sideridispas/SdR_Thesis/README.md

# SdR_Thesis
Code for my thesis. All libraries that I had to include and all the code that I wrote for the 2 arduinos and the processing apps.
