sideridispas/SdR_Thesis/Thesis_Report/chapters/4.ControlData.tex

Introduction text here...
mpla mpla mpla about the control of the PCB and the data handling

\section{Requirements}
List of technical requirements such as
time
I2C communication
Data format
Etc

\section{Main CPU and Logic}
Raspberry Pi
OS, Wifi, Cron timing, remote control etc

\section{Data Logging and Storing}
Data logging from the PCB
Local storing
Cloud uploading
