sideridispas/SdR_Thesis/Thesis_Report/chapters/5.FinalDevice.tex

Introduction text maybe here...
mpla mpla mpla

\section{Physical Requirements}
IP66
Weather resistance
dimensions
temperature and UV exposure
etc

\section{Power Supply}
5V Voltage regulator
24V Power supply externally
Custom Voltage regulation PCB
Alternatives

\section{Enclosure and Connections}
Enclosure selection
PV connectors
Power supply connectors
Temperature 1-wire bus connector
Photos and 3D draft

\section{Calibration}
Introduction for calibration like we need it after we have all the components with their resistances (connectors, welded points etc)

\subsection{Tools and Setup}
Tools that were used
Circuit of the calibration setup

\subsection{Process}
Initial measurement
Calculation of Correction parameters
Update of atmega code
Final Measurement
Validation of calibration

Results (???)
