sideridispas/SdR_Thesis/Thesis_Report/chapters/system_abstract.png

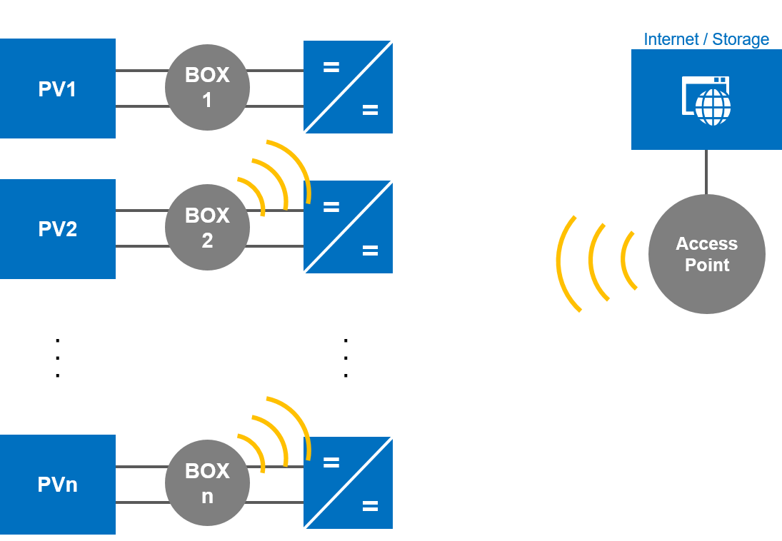
Thesis_Report/chapters/system_abstract.png
