sideridispas/SdR_Thesis/Thesis_Report/images/Chapter_3/PV_demoPCB_bottom.jpg

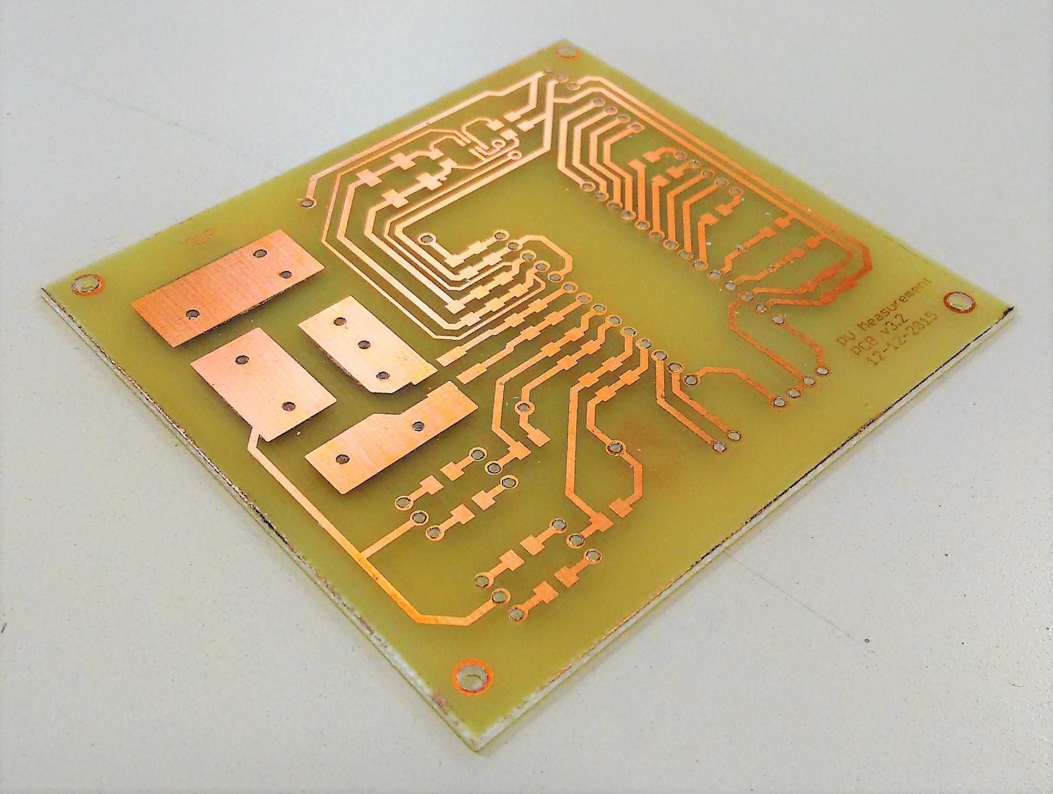
Thesis_Report/images/Chapter_3/PV_demoPCB_bottom.jpg
