sideridispas/SdR_Thesis/Calibration/After Calibration/Calibrated.xlsx

DMM | PCB | Error
4.923094 | 4.9087
4.923264 | 4.9214
4.923207 | 4.9017
4.923103 | 4.9186
4.923118 | 4.9094
4.923204 | 4.914
4.923100 | 4.9205
4.923058 | 4.9148
1.981027 | 1.9657
1.977889 | 1.9713
1.977085 | 1.9683
1.976761 | 1.9661
1.976463 | 1.9687
1.976314 | 1.9652
0.998007 | 1.9632
0.997257 | 1.1259
0.996954 | 0.9889
0.996847 | 0.9811
0.996625 | 0.9792
0.996527 | 0.976
0.996494 | 0.9851
0.996425 | 0.976
0.996337 | 0.9781
0.996292 | 0.9931
0.996339 | 0.9775
0.996231 | 0.9765
0.996199 | 0.9818
0.996292 | 0.9854
0.996162 | 0.9795
1.974760 | 0.9894
1.975188 | 0.979
1.975251 | 0.9814
1.975322 | 0.9744
1.975424 | 0.9734
1.975456 | 0.985
1.975439 | 0.9773
1.975459 | 1.9522
1.975522 | 1.9606
1.975474 | 1.9684
1.975495 | 1.9578
1.975578 | 1.9577
1.975495 | 1.961
1.975519 | 1.9576
1.975523 | 1.9563
3.864551 | 1.9592
3.932944 | 1.9614
3.933947 | 1.9624
3.934322 | 1.9668
3.934611 | 1.9597
3.934659 | 1.9562
3.934745 | 1.9538
3.934823 | 1.9585
3.934968 | 1.9605
3.934924 | 1.9581
3.934962 | 1.962
3.935087 | 1.956
3.935013 | 3.9248
3.935034 | 3.9251
3.935038 | 3.9149
3.935126 | 3.9175
5.882725 | 3.9244
5.901049 | 3.9215
5.902201 | 3.9126
5.902701 | 3.926
5.902892 | 3.926
5.903056 | 3.9301
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
