sideridispas/SdR_Thesis/Calibration/BeforeCalibration/1/calibration.xlsx

DMM | PCB | Voltage step | DMM-Avg | PCB-Avg | Error
0.995823 | 1.0289 | 1 | 0.995849 | 1.0289 | 3.318891
0.995832 | 1.0289 | 5 | 4.922126 | 4.97372 | 1.048209
0.995915 | 1.029 | 2 | 1.976426 | 2.014557143 | 1.929308
0.995834 | 1.0286 | 1 | 0.996097 | 1.029552632 | 3.358656
0.995824 | 1.0288 | 2 | 1.975369 | 2.013094737 | 1.909792
0.995827 | 1.029 | 4 | 3.934673 | 3.9818 | 1.197734
0.995926 | 1.0289 | 6 | 5.902928 | 5.9595 | 0.958374
0.995827 | 1.0288 | 8 | 7.872826 | 7.938952632 | 0.839935
0.995833 | 1.0291 | 10 | 9.843440 | 9.918910526 | 0.766707
0.995892 | 1.0292 | 12 | 11.814864 | 11.89970526 | 0.718090
0.995833 | 1.0291 | 14 | 13.788631 | 13.88143158 | 0.673025
0.995819 | 1.0285 | 16 | 15.760363 | 15.86362632 | 0.655211
0.995861 | 4.95 | 18 | 17.733738 | 17.84630556 | 0.634765
0.995884 | 4.9708 | 20 | 19.699575 | 19.820695 | 0.614837
0.995828 | 4.973 | 22 | 21.664912 | 21.79542632 | 0.602423
0.995824 | 4.9736 | 24 | 23.632830 | 23.7718 | 0.588038
4.919913 | 4.974 | 26 | 25.600987 | 25.74749474 | 0.572275
4.921187 | 4.974 | 28 | 27.560138 | 27.71546316 | 0.563586
4.921830 | 4.9746 | 30 | 29.526013 | 29.68931579 | 0.553082
4.922060 | 4.9745 | 32 | 31.490387 | 31.6583 | 0.533221
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
