sideridispas/SdR_Thesis/Calibration/BeforeCalibration/2/data_2016-05-23-17.csv

Date | Time | I | V1 | V2 | P | Temp1 | Temp2 | Temp3 | Temp4 | Temp5 | Temp6 | Temp7 | Temp8 | Temp9 | Temp10 | Temp11 | Temp12 | Temp13 | Temp14 | Temp15 | Temp16 | Temp17 | Temp18 | Temp19 | Temp20 | ComputerTime | Corrupted
23/5/16 | 3:26:33 | 2.3385 | 7.9401 | 50.7375 | 18.5681 | 99.99 | 99.99 | 99.99 | 99.99 | 99.99 | 99.99 | 99.99 | 99.99 | 99.99 | 99.99 | 99.99 | 99.99 | 99.99 | 99.99 | 99.99 | 99.99 | 99.99 | 99.99 | 99.99 | 99.99 | 2016-05-23 17:25:35.253465
23/5/16 | 14:45:34 | 1.8224 | 7.9399 | 7.9162 | 14.4700 | 99.99 | 99.99 | 99.99 | 99.99 | 99.99 | 99.99 | 99.99 | 99.99 | 99.99 | 99.99 | 99.99 | 99.99 | 99.99 | 99.99 | 99.99 | 99.99 | 99.99 | 99.99 | 99.99 | 99.99 | 2016-05-23 17:25:35.570091
23/5/16 | 14:24:35 | 1.8223 | 7.9396 | 7.9161 | 14.4688 | 99.99 | 99.99 | 99.99 | 99.99 | 99.99 | 99.99 | 99.99 | 99.99 | 99.99 | 99.99 | 99.99 | 99.99 | 99.99 | 99.99 | 99.99 | 99.99 | 99.99 | 99.99 | 99.99 | 99.99 | 2016-05-23 17:25:36.692690
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
