sideridispas/SdR_Thesis/Calibration/BeforeCalibration/2/meas0003.csv

 |  | 23-MAY-2016 | 18:25:25 | 2199203
7.8740410E+00 | Vdc
7.8740500E+00 | Vdc
7.8740980E+00 | Vdc
7.8740210E+00 | Vdc
7.8740380E+00 | Vdc
7.8741040E+00 | Vdc
1.0009973E+00 | Vdc
9.9898150E-01 | Vdc
9.9808070E-01 | Vdc
9.9765600E-01 | Vdc
9.9721940E-01 | Vdc
9.9699240E-01 | Vdc
9.9686820E-01 | Vdc
9.9665940E-01 | Vdc
9.9655900E-01 | Vdc
9.9648190E-01 | Vdc
9.9644550E-01 | Vdc
9.9632460E-01 | Vdc
9.9625610E-01 | Vdc
9.9627310E-01 | Vdc
9.9617060E-01 | Vdc
1.9746480E+00 | Vdc
1.9751190E+00 | Vdc
1.9751810E+00 | Vdc
1.9752640E+00 | Vdc
1.9753420E+00 | Vdc
1.9754550E+00 | Vdc
1.9753600E+00 | Vdc
1.9754070E+00 | Vdc
1.9754730E+00 | Vdc
1.9754160E+00 | Vdc
1.9754100E+00 | Vdc
1.9754700E+00 | Vdc
1.9754760E+00 | Vdc
1.9754310E+00 | Vdc
1.9754100E+00 | Vdc
3.9286160E+00 | Vdc
3.9332880E+00 | Vdc
3.9340140E+00 | Vdc
3.9343570E+00 | Vdc
3.9345830E+00 | Vdc
3.9348030E+00 | Vdc
3.9348000E+00 | Vdc
3.9348690E+00 | Vdc
3.9349820E+00 | Vdc
3.9349550E+00 | Vdc
3.9349910E+00 | Vdc
3.9350980E+00 | Vdc
3.9350710E+00 | Vdc
3.9350710E+00 | Vdc
3.9350860E+00 | Vdc
3.9351990E+00 | Vdc
5.8847400E+00 | Vdc
5.9008980E+00 | Vdc
5.9022470E+00 | Vdc
5.9027560E+00 | Vdc
5.9030870E+00 | Vdc
5.9032240E+00 | Vdc
5.9033550E+00 | Vdc
5.9034980E+00 | Vdc
5.9035010E+00 | Vdc
5.9035480E+00 | Vdc
5.9036940E+00 | Vdc
5.9036410E+00 | Vdc
5.9036850E+00 | Vdc
5.9037000E+00 | Vdc
5.9038190E+00 | Vdc
5.9037450E+00 | Vdc
7.8622590E+00 | Vdc
7.8715220E+00 | Vdc
7.8725470E+00 | Vdc
7.8729840E+00 | Vdc
7.8733300E+00 | Vdc
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
7.8678630E+00 | Vdc
7.8693520E+00 | Vdc
7.8697150E+00 | Vdc
7.8695420E+00 | Vdc
7.8701350E+00 | Vdc
7.8703760E+00 | Vdc
7.8707360E+00 | Vdc
7.8705700E+00 | Vdc
7.8706740E+00 | Vdc
7.8705460E+00 | Vdc
7.8705280E+00 | Vdc
7.8709180E+00 | Vdc
7.8714750E+00 | Vdc
 |  | 23-MAY-2016 | 18:33:50
