sideridispas/SdR_Thesis/Calibration/After Calibration/data_2016-05-23-20.csv

Date | Time | I | V1 | V2 | P | Temp1 | Temp2 | Temp3 | Temp4 | Temp5 | Temp6 | Temp7 | Temp8 | Temp9 | Temp10 | Temp11 | Temp12 | Temp13 | Temp14 | Temp15 | Temp16 | Temp17 | Temp18 | Temp19 | Temp20 | ComputerTime | Corrupted
23/5/16 | 0:5:8 | 1.4462 | 4.9087 | -15.5217 | 7.0993 | 99.99 | 99.99 | 99.99 | 99.99 | 99.99 | 99.99 | 99.99 | 99.99 | 99.99 | 99.99 | 99.99 | 99.99 | 99.99 | 99.99 | 99.99 | 99.99 | 99.99 | 99.99 | 99.99 | 99.99 | 2016-05-23 20:09:10.144436
23/5/16 | 20:8:9 | 1.1234 | 4.9214 | 4.9923 | 5.5285 | 99.99 | 99.99 | 99.99 | 99.99 | 99.99 | 99.99 | 99.99 | 99.99 | 99.99 | 99.99 | 99.99 | 99.99 | 99.99 | 99.99 | 99.99 | 99.99 | 99.99 | 99.99 | 99.99 | 99.99 | 2016-05-23 20:09:10.461809
23/5/16 | 20:12:10 | 1.1233 | 4.9017 | 4.9844 | 5.5062 | 99.99 | 99.99 | 99.99 | 99.99 | 99.99 | 99.99 | 99.99 | 99.99 | 99.99 | 99.99 | 99.99 | 99.99 | 99.99 | 99.99 | 99.99 | 99.99 | 99.99 | 99.99 | 99.99 | 99.99 | 2016-05-23 20:09:11.511436
23/5/16 | 20:8:11 | 1.1236 | 4.9186 | 4.9846 | 5.5264 | 99.99 | 99.99 | 99.99 | 99.99 | 99.99 | 99.99 | 99.99 | 99.99 | 99.99 | 99.99 | 99.99 | 99.99 | 99.99 | 99.99 | 99.99 | 99.99 | 99.99 | 99.99 | 99.99 | 99.99 | 2016-05-23 20:09:12.543466
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
