sideridispas/SdR_Thesis/Calibration/BOX1/V1/Before/toCalibrate.xlsx

DMM | PCB
0.9985933917 | 0.9853235294
1.979672923 | 1.962041176
3.943655462 | 3.916494118
5.916801846 | 5.879911765
7.891076615 | 7.844323529
9.866348462 | 9.809917647
11.84264677 | 11.7765
13.81991083 | 13.74407647
15.79753077 | 15.71231765
17.77633615 | 17.68140588
19.74741571 | 19.64044706
21.71932154 | 21.60451176
23.69067769 | 23.56627647
25.66340615 | 25.52883529
27.62965615 | 27.48558824
29.60411538 | 29.45053529
31.57876462 | 31.41466471
33.55179462 | 33.37836471
35.51564308 | 35.33141176
39.46162538 | 39.25578824
1.001846382 | 0.9895470588
1.978930692 | 1.961182353
3.942882 | 3.915041176
