sideridispas/SdR_Thesis/Calibration/After Calibration/Matlab/rawdata.png

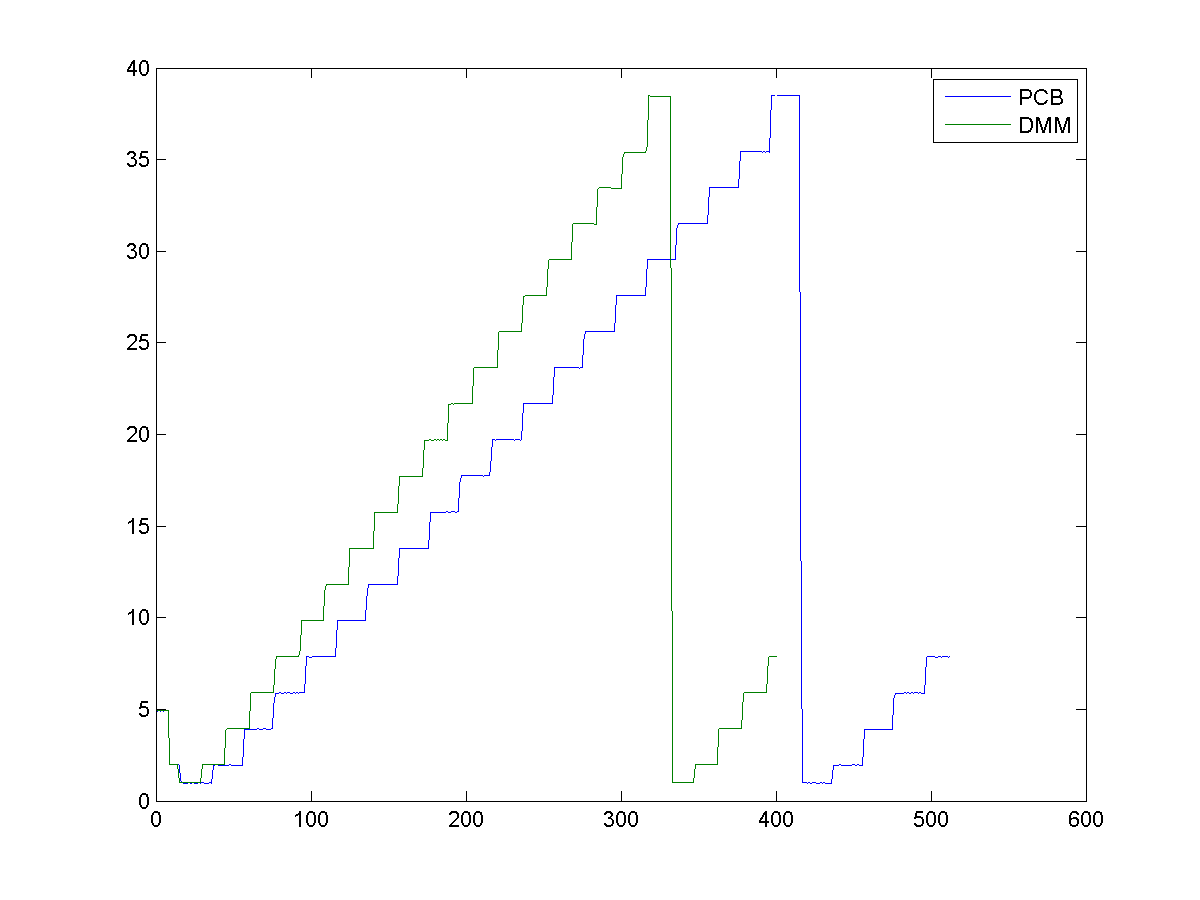
Calibration/After Calibration/Matlab/rawdata.png
