sideridispas/SdR_Thesis/Calibration/After Calibration/Matlab/rawdata_before.png

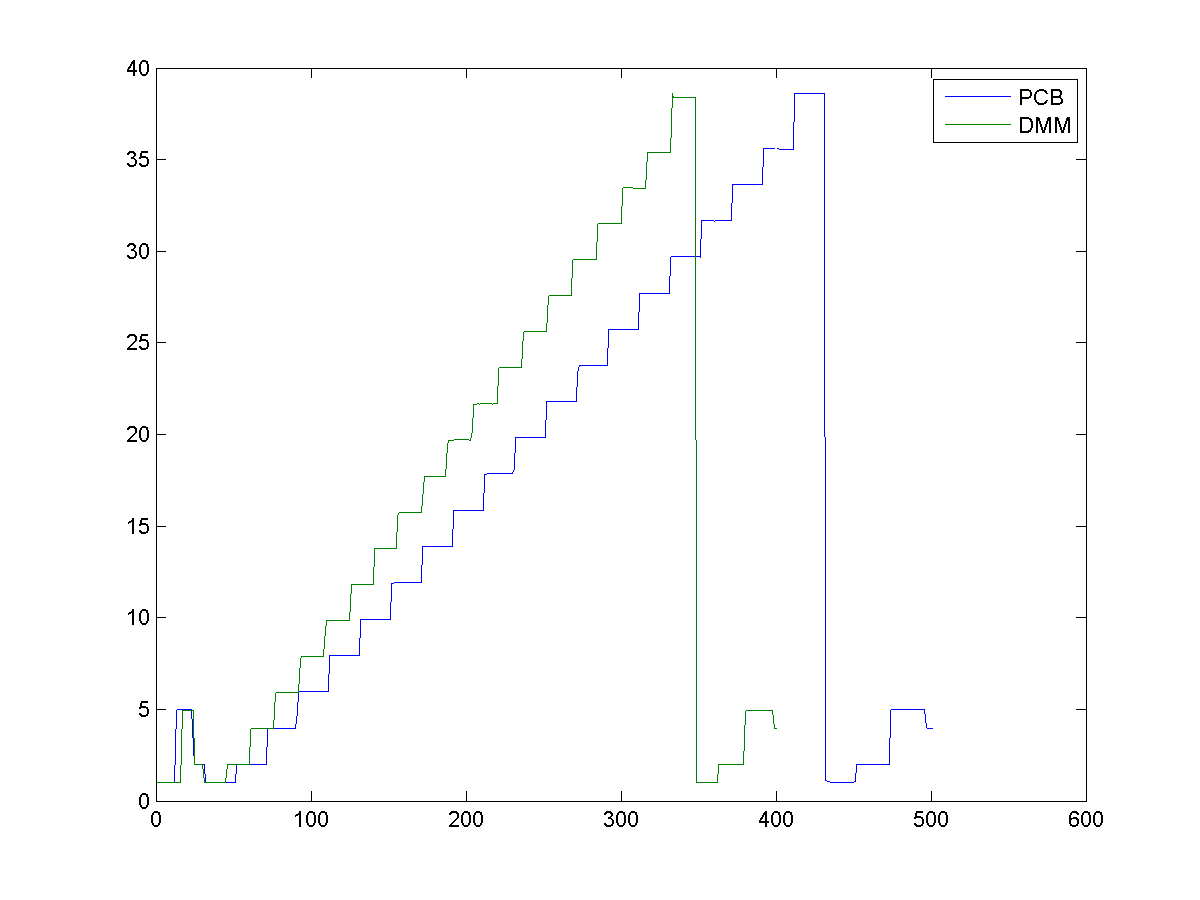
Calibration/After Calibration/Matlab/rawdata_before.png
