sideridispas/SdR_Thesis/Calibration/Before/difference_before.png

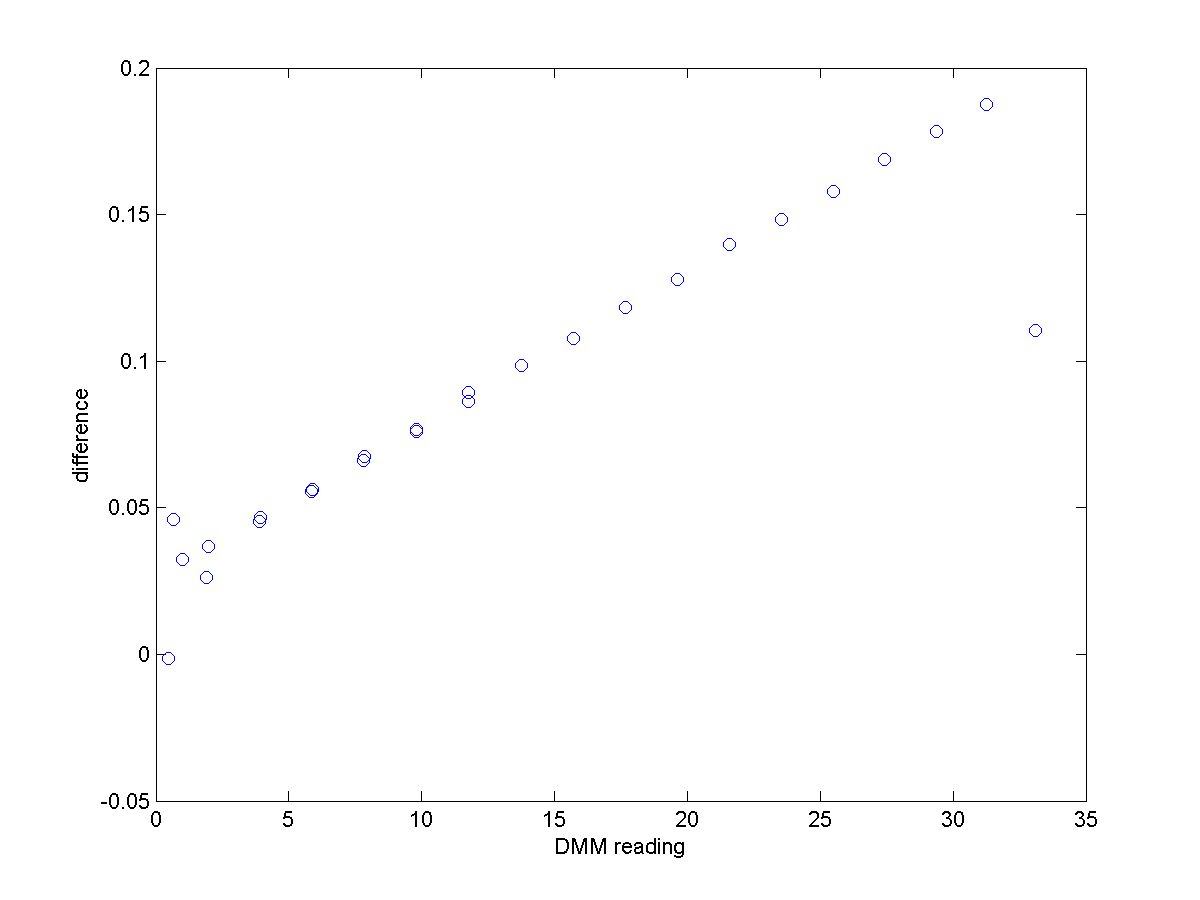
Calibration/Before/difference_before.png
