sideridispas/SdR_Thesis/Calibration/Before/Means_before.png

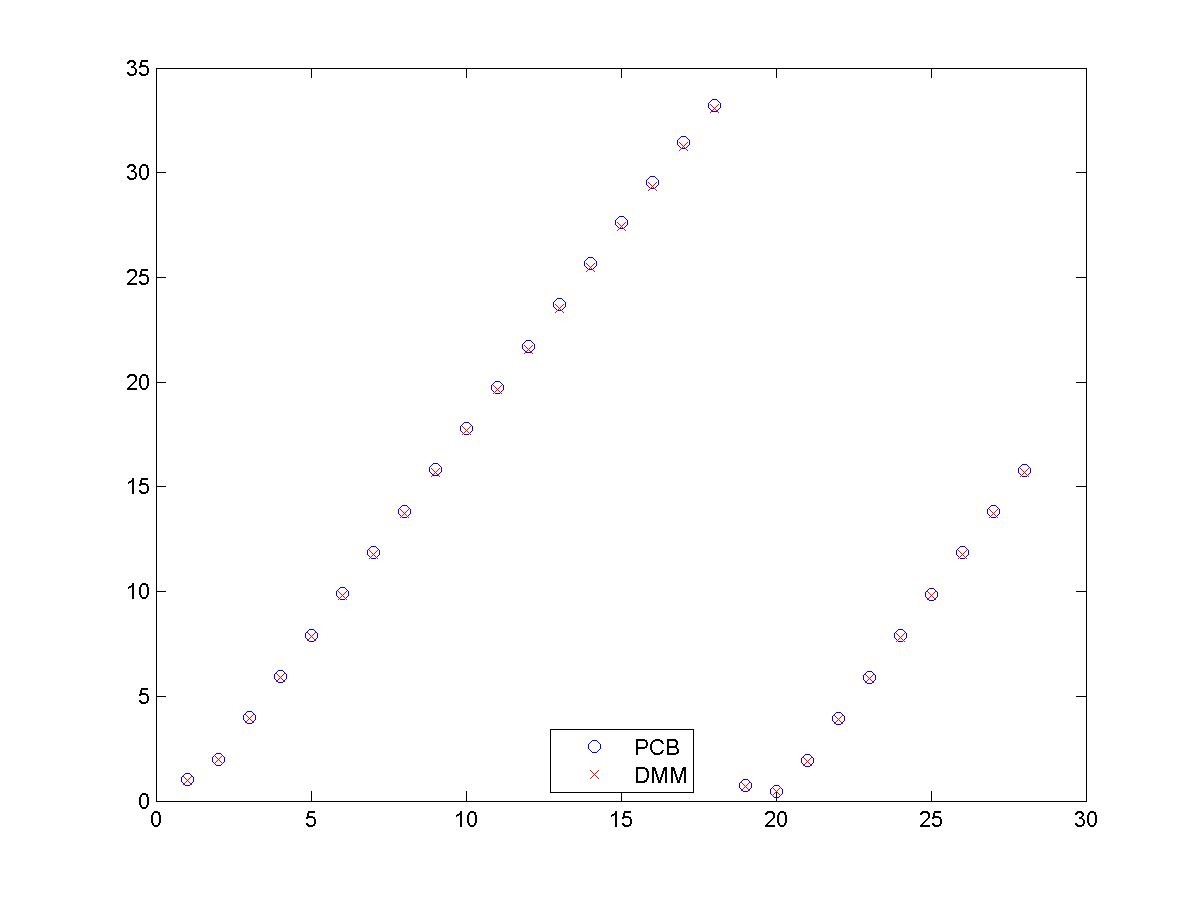
Calibration/Before/Means_before.png
