sideridispas/SdR_Thesis/Calibration/Before/RawData_before.png

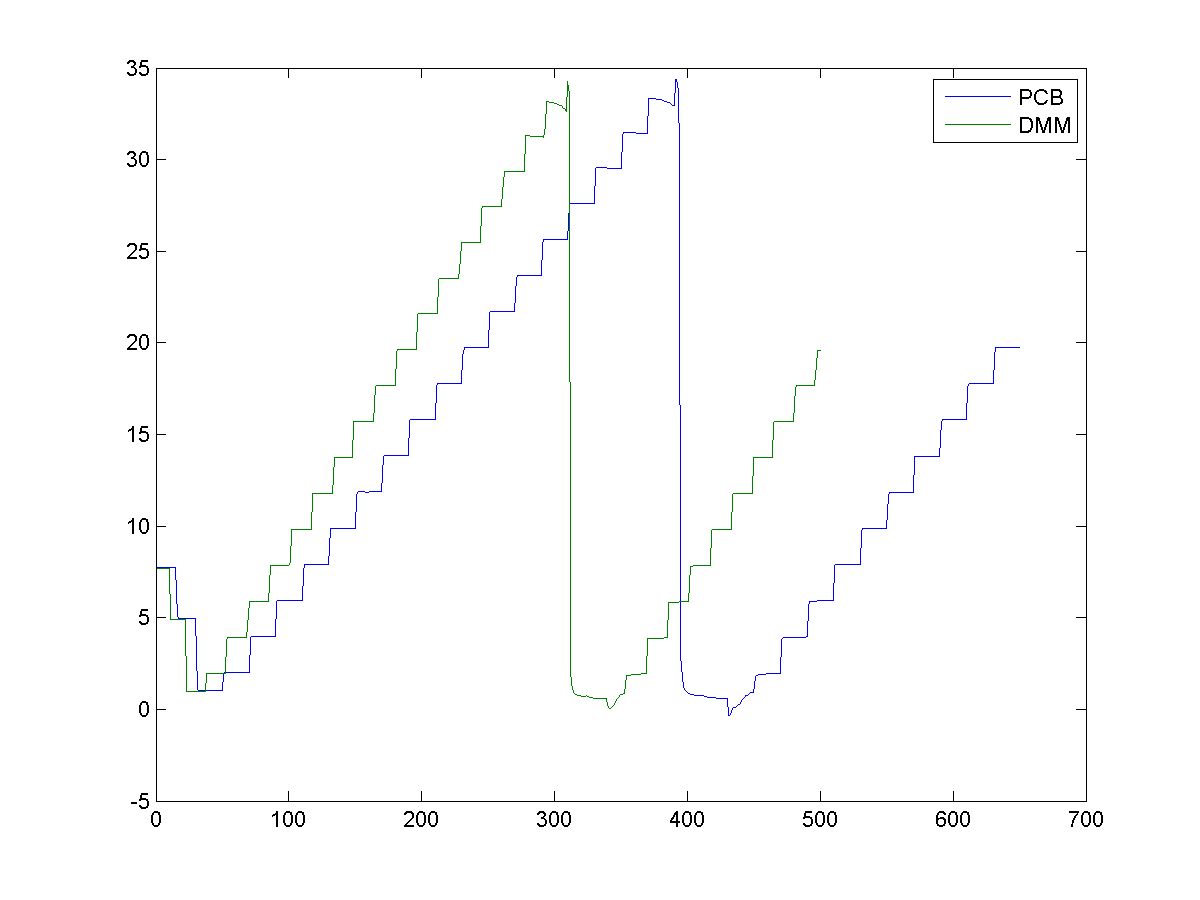
Calibration/Before/RawData_before.png
