sideridispas/SdR_Thesis/Calibration/BOX1/I/After/difference.png

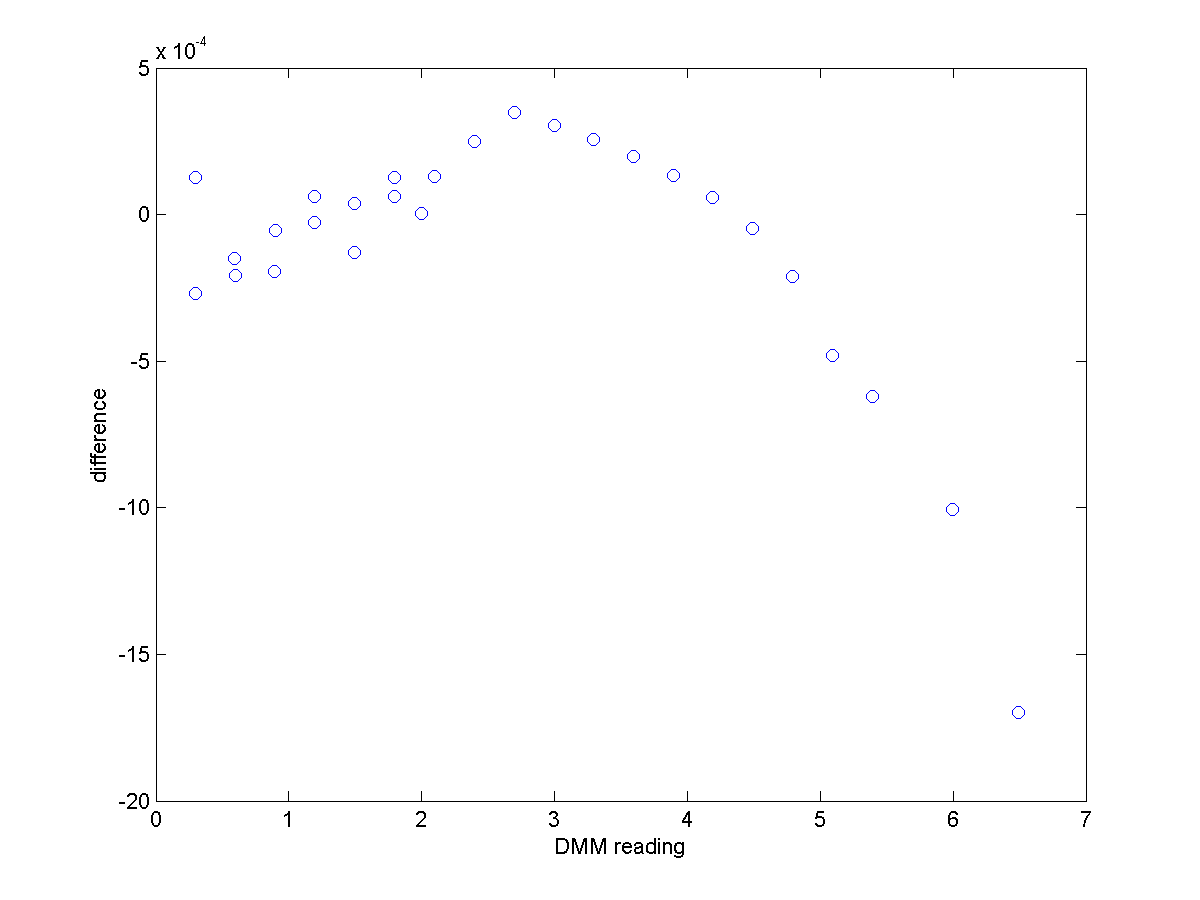
Calibration/BOX1/I/After/difference.png
