sideridispas/SdR_Thesis/Calibration/BOX1/I/After/Means.png

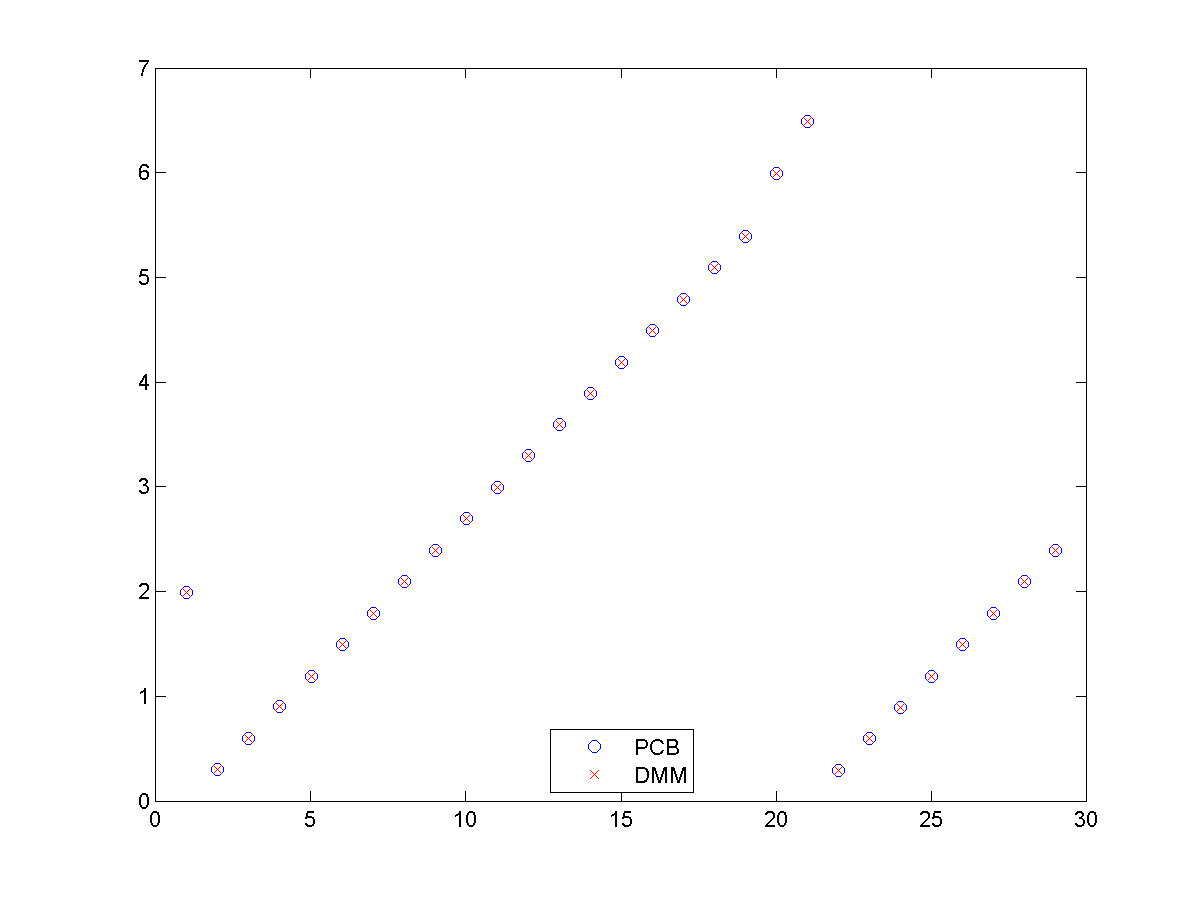
Calibration/BOX1/I/After/Means.png
