sideridispas/SdR_Thesis/Calibration/BOX1/I/After/RawData.png

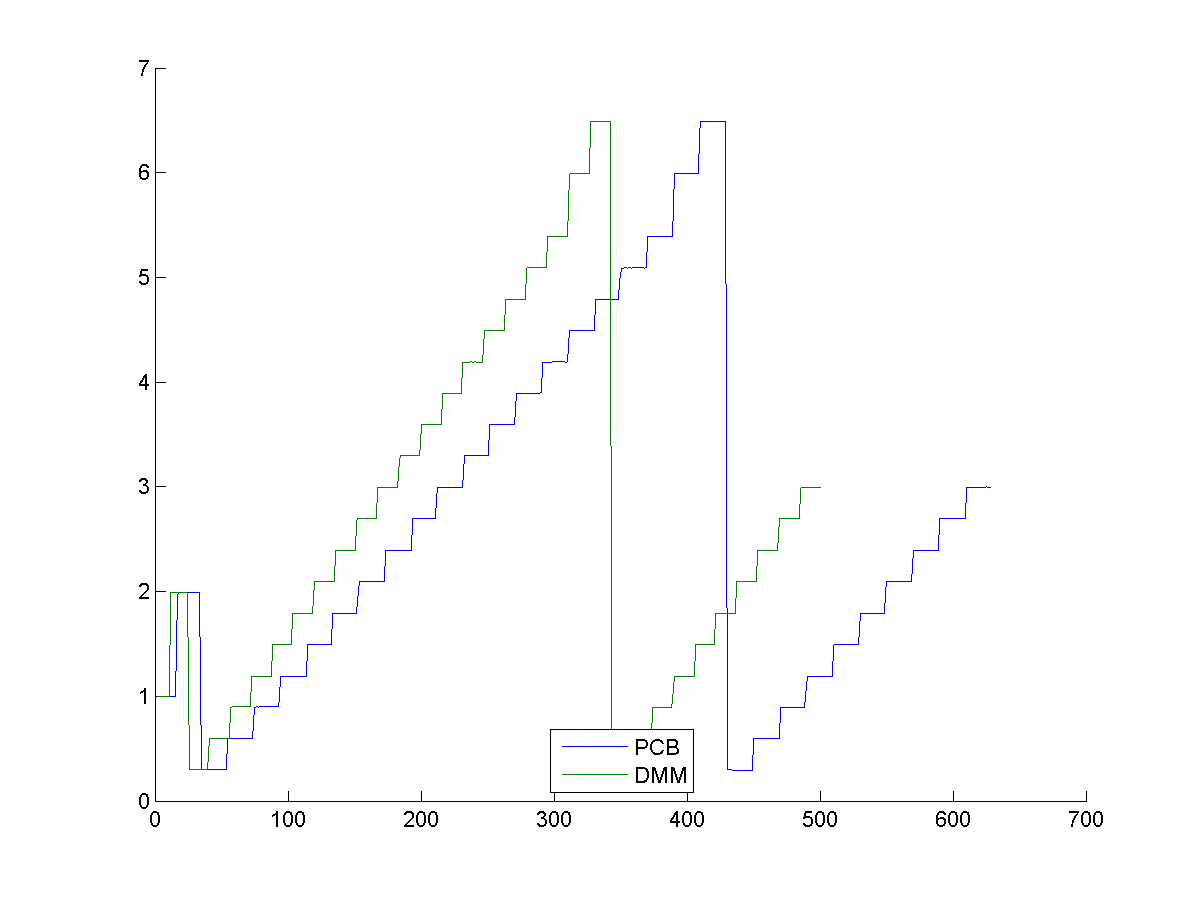
Calibration/BOX1/I/After/RawData.png
