sideridispas/SdR_Thesis/Calibration/BOX1/I/After/scatter.png

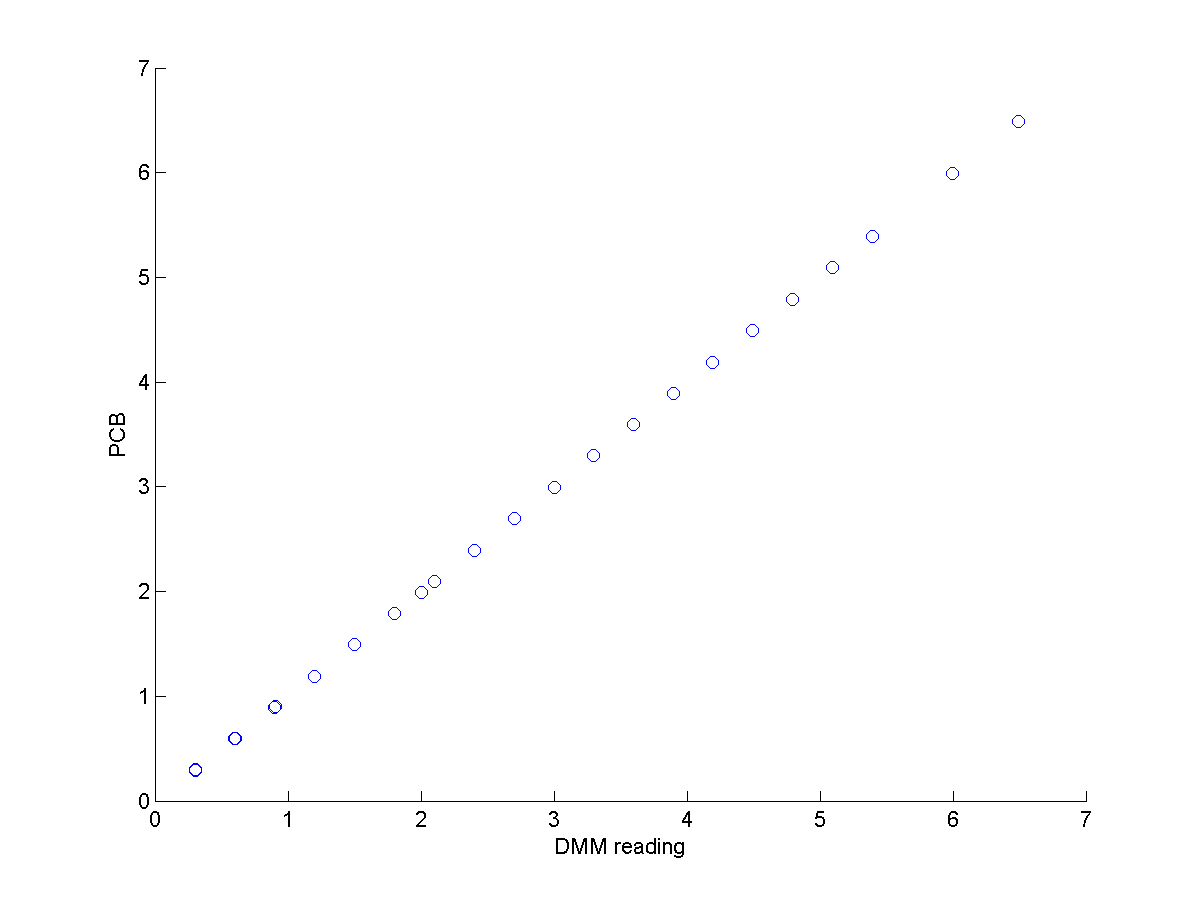
Calibration/BOX1/I/After/scatter.png
