sideridispas/SdR_Thesis/Calibration/BOX1/I/After/scatter_trendLine.png

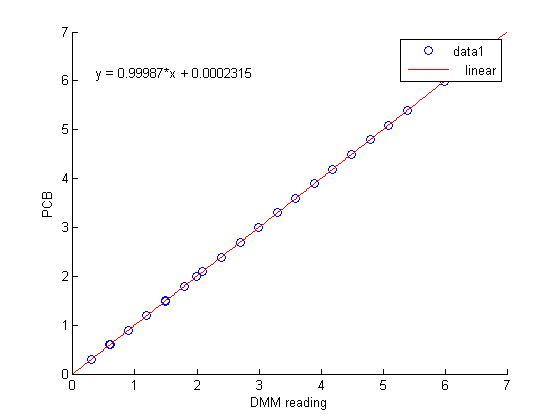
Calibration/BOX1/I/After/scatter_trendLine.png
