sideridispas/SdR_Thesis/Calibration/BOX1/I/Before/difference.png

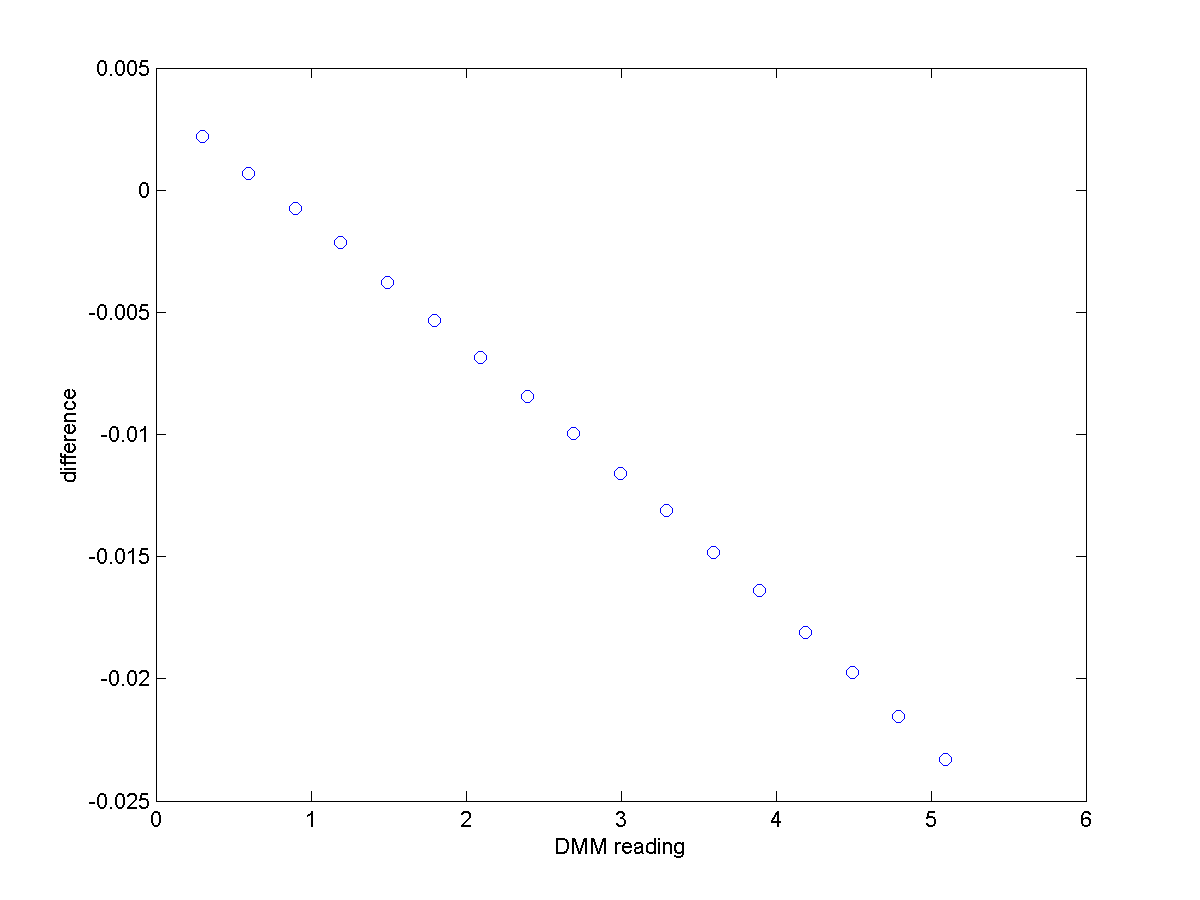
Calibration/BOX1/I/Before/difference.png
