sideridispas/SdR_Thesis/Calibration/BOX1/I/Before/FailTry/difference.png

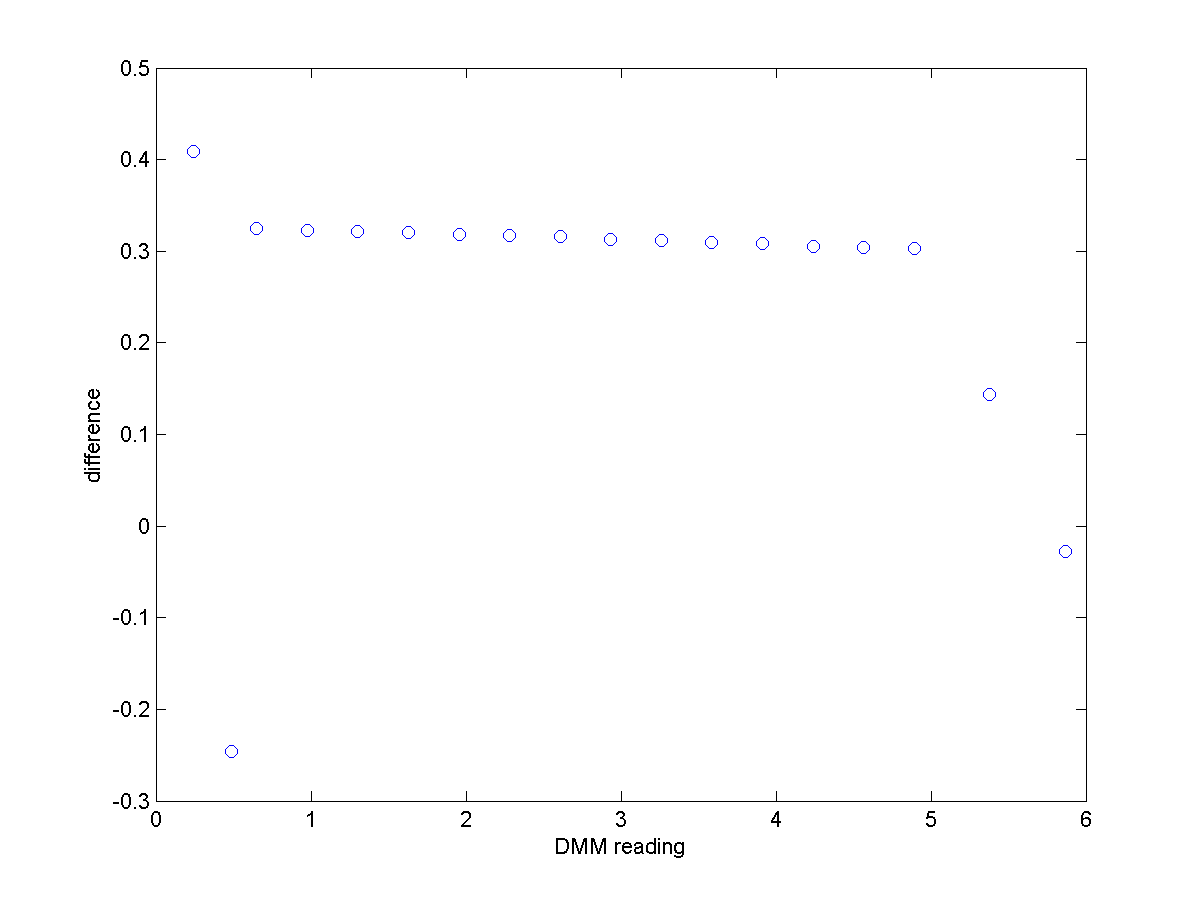
Calibration/BOX1/I/Before/FailTry/difference.png
