sideridispas/SdR_Thesis/Calibration/BOX1/I/Before/FailTry/Means.png

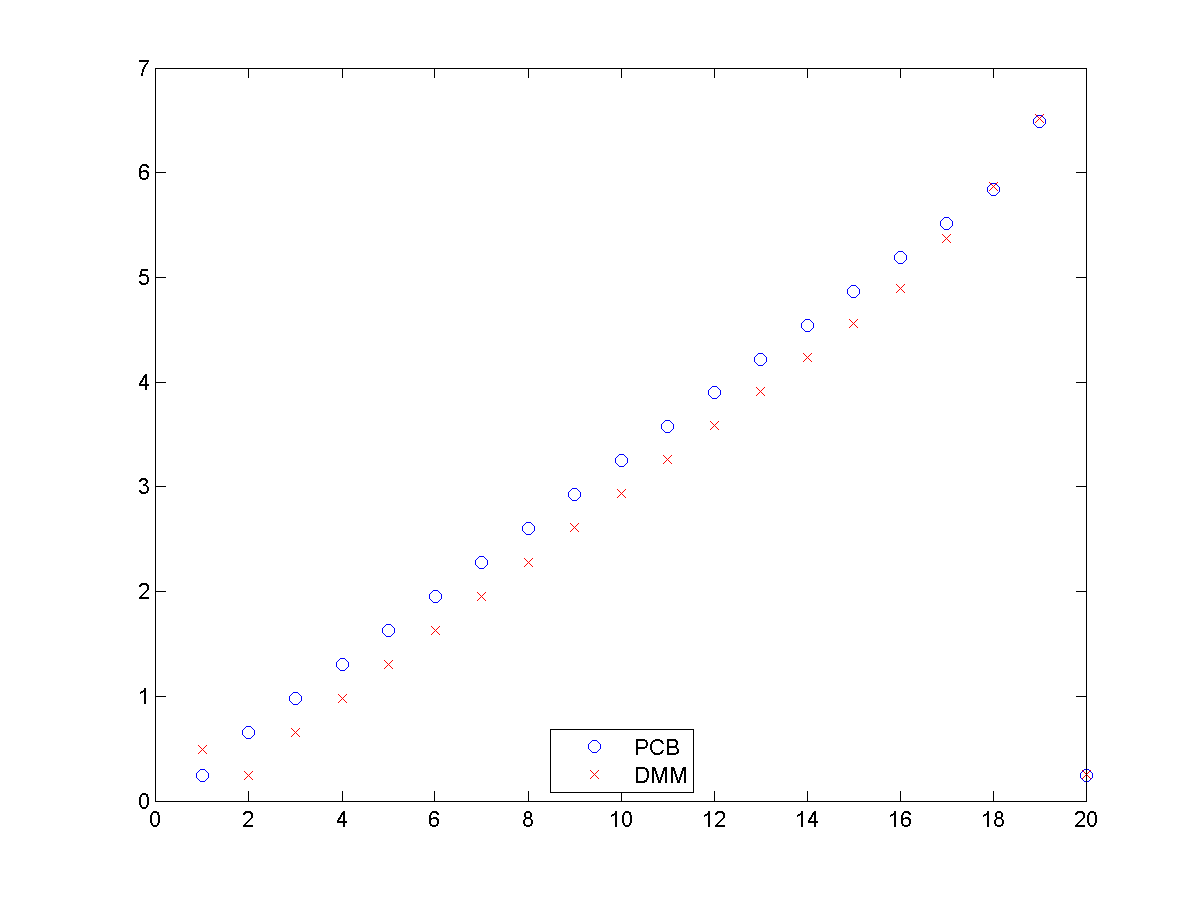
Calibration/BOX1/I/Before/FailTry/Means.png
