sideridispas/SdR_Thesis/Calibration/BOX1/I/Before/FailTry/scatter.png

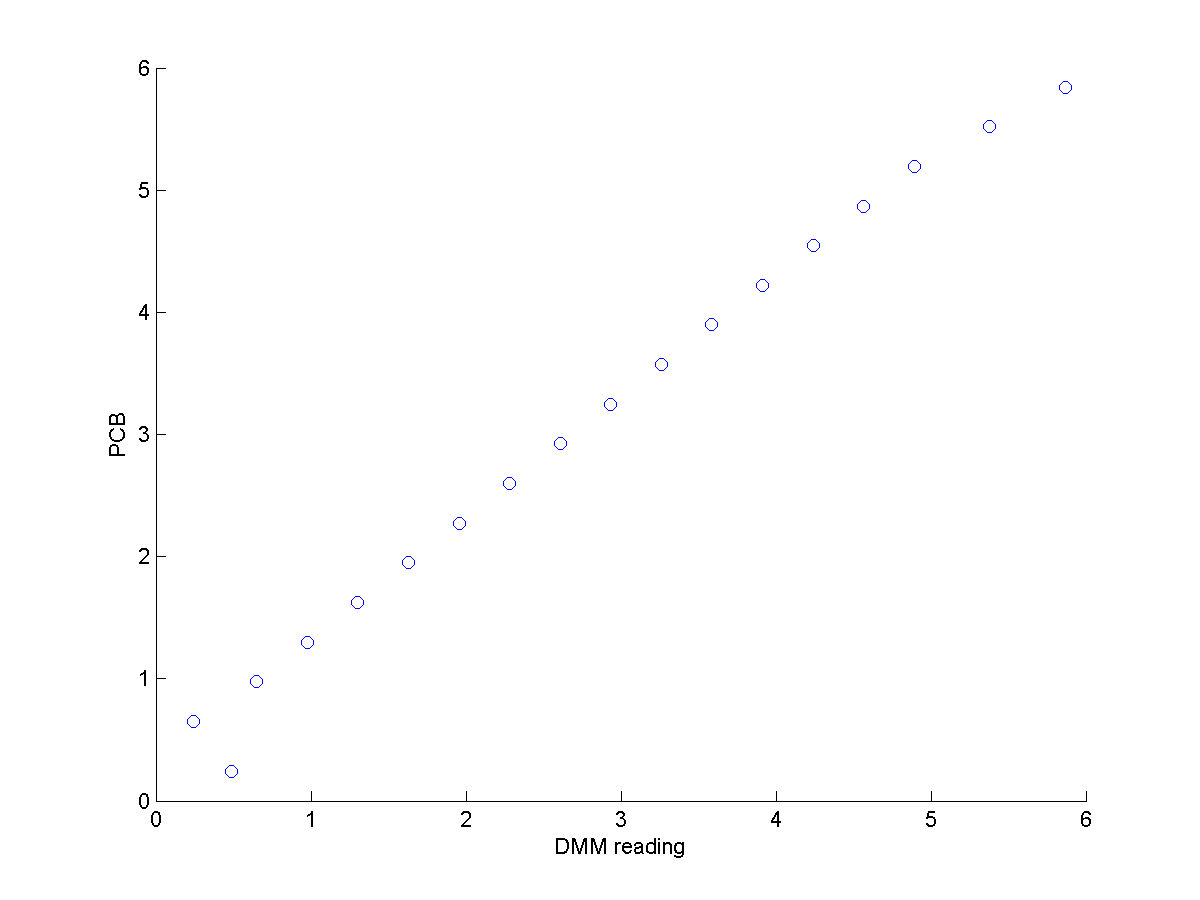
Calibration/BOX1/I/Before/FailTry/scatter.png
