sideridispas/SdR_Thesis/Calibration/BOX1/I/Before/FailTry/scatter_trendLine.png

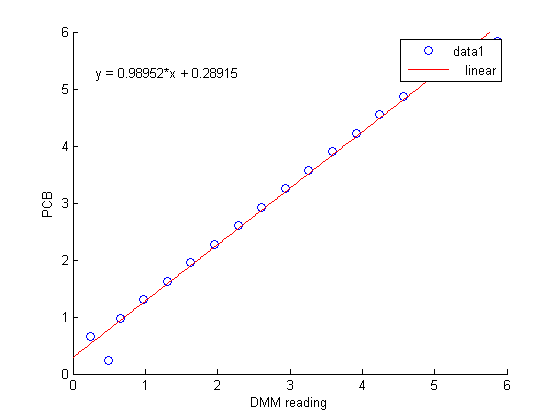
Calibration/BOX1/I/Before/FailTry/scatter_trendLine.png
