sideridispas/SdR_Thesis/Calibration/BOX1/I/Before/RawData.png

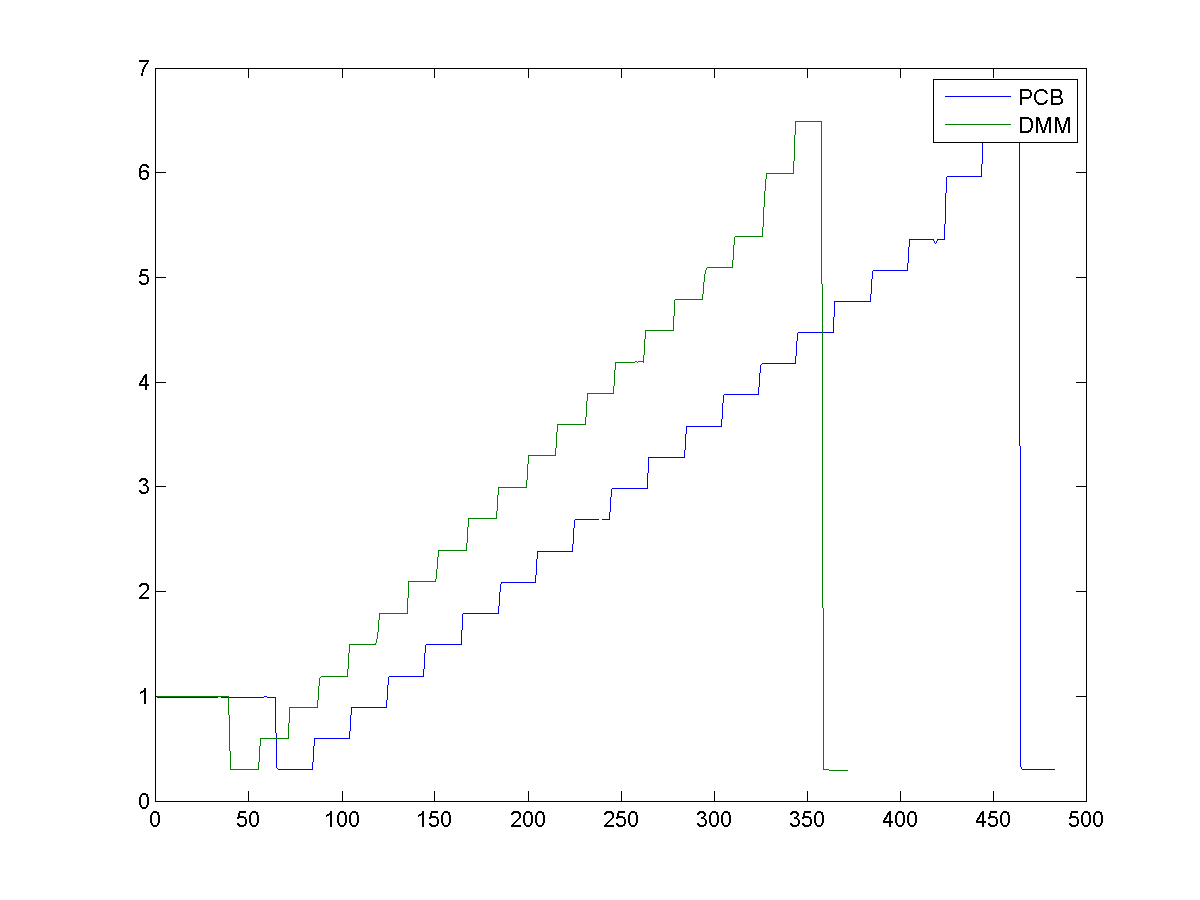
Calibration/BOX1/I/Before/RawData.png
