sideridispas/SdR_Thesis/Calibration/BOX1/I/Before/scatter.png

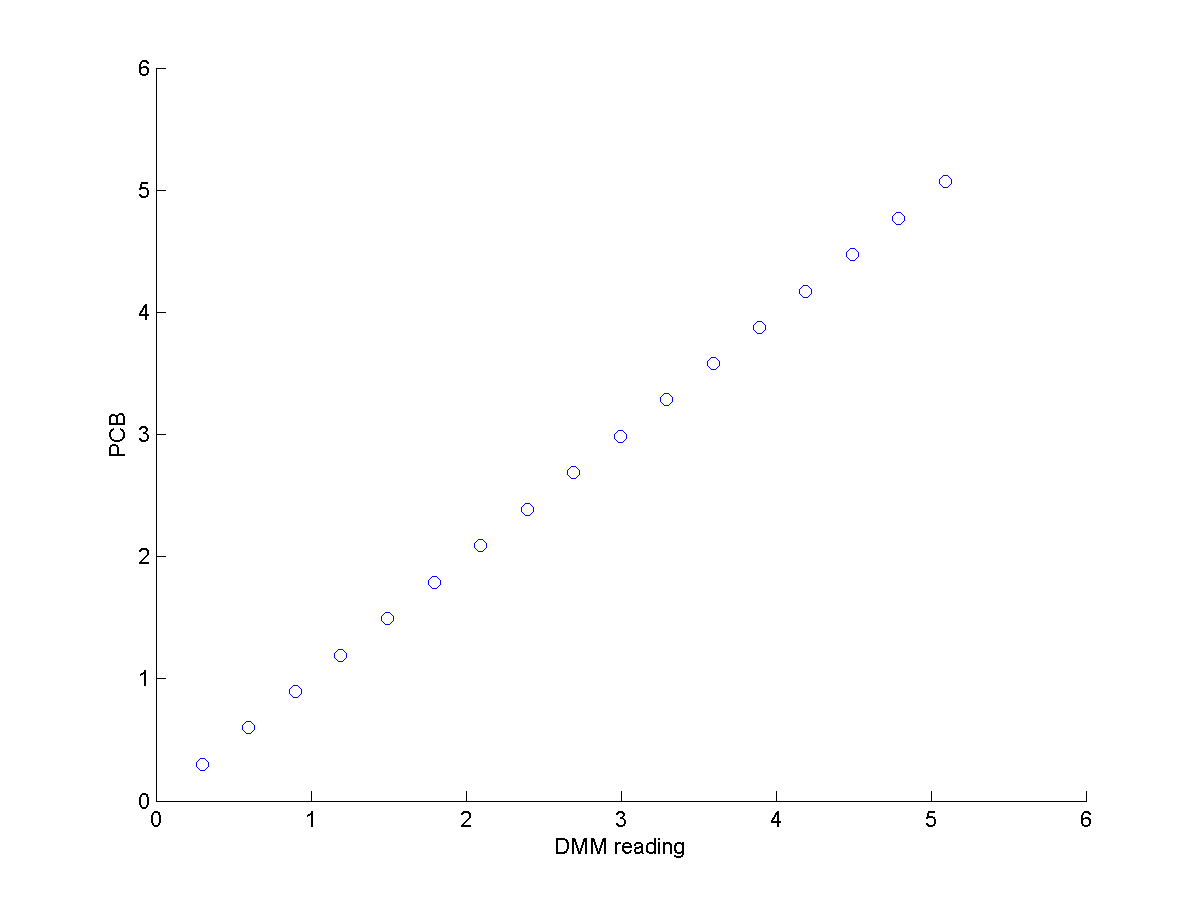
Calibration/BOX1/I/Before/scatter.png
