sideridispas/SdR_Thesis/Calibration/BOX1/V2/After/difference.png

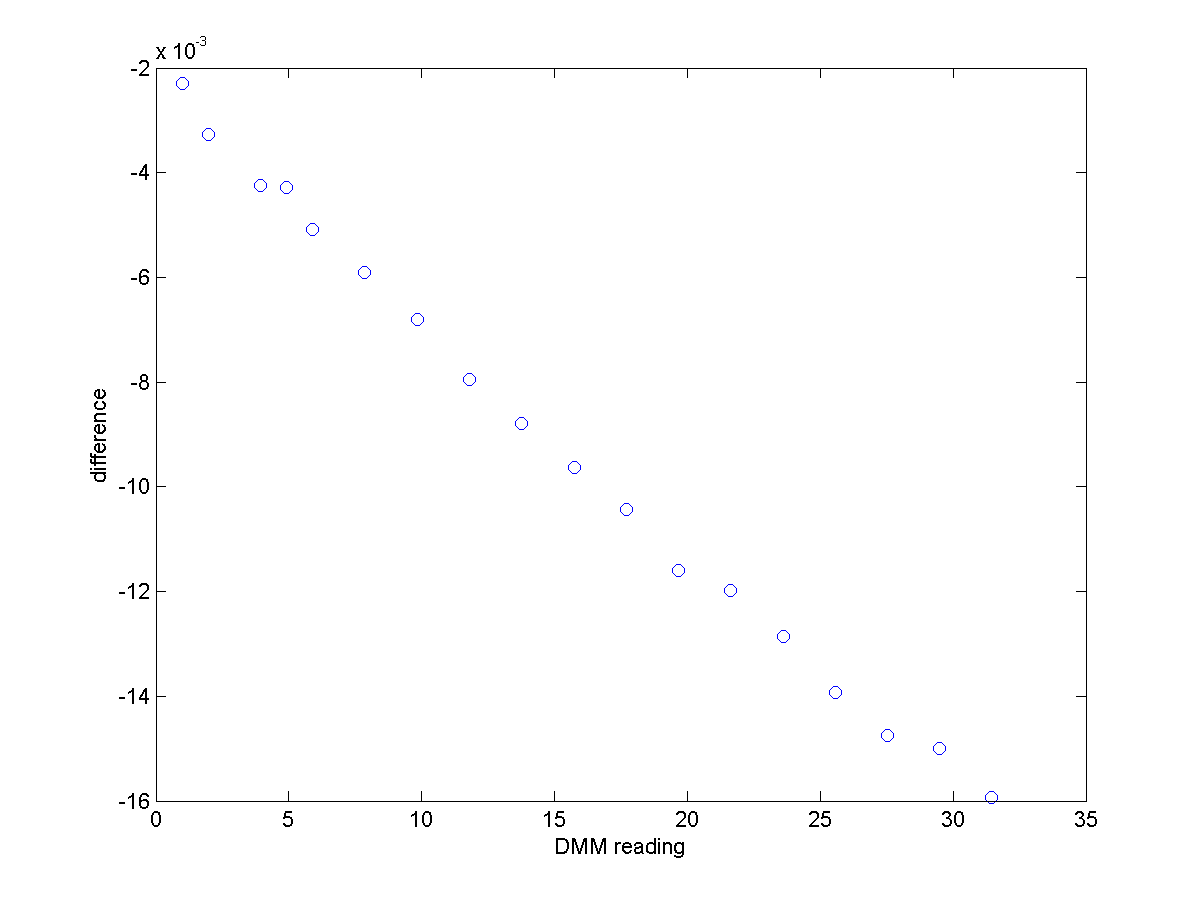
Calibration/BOX1/V2/After/difference.png
