sideridispas/SdR_Thesis/Calibration/BOX1/V2/After/scatter.png

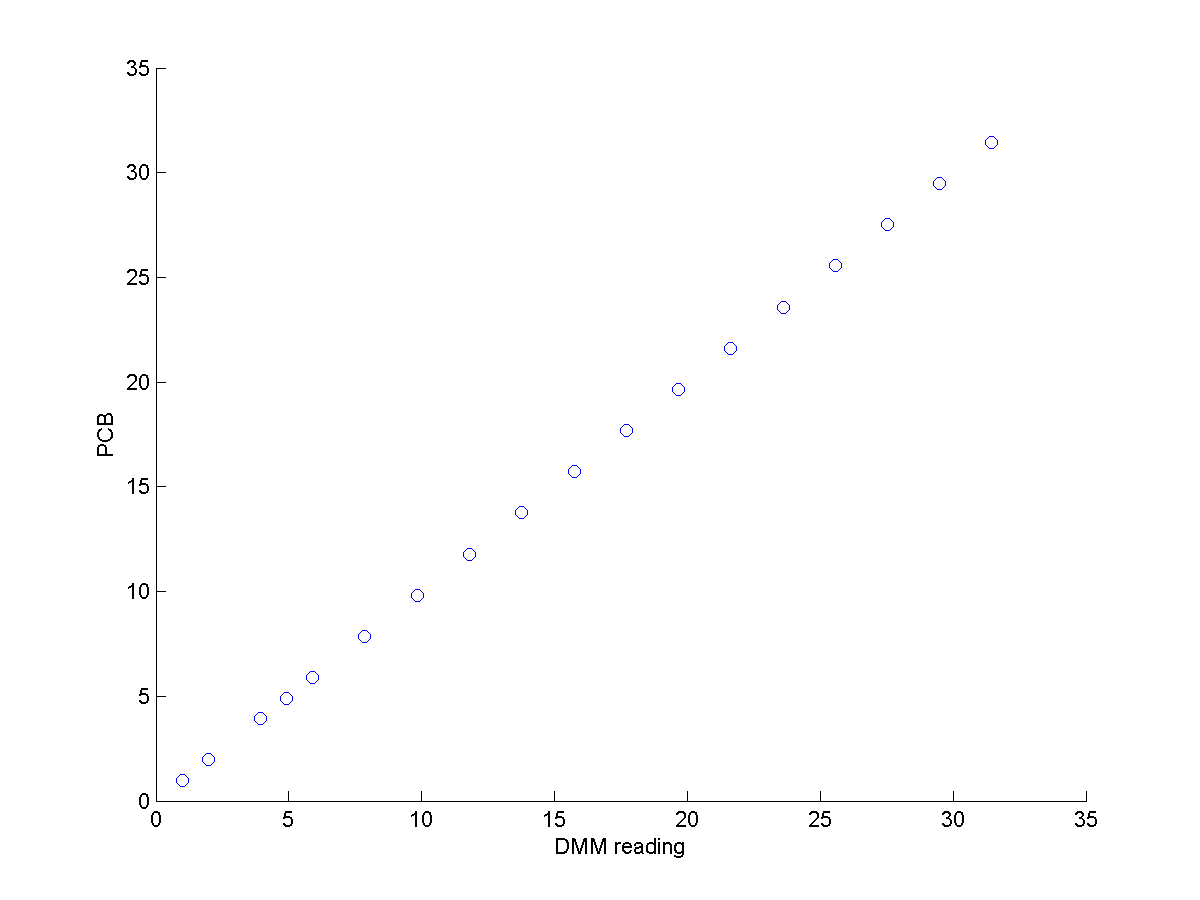
Calibration/BOX1/V2/After/scatter.png
