sideridispas/SdR_Thesis/Calibration/BOX1/V2/Before/RawData.png

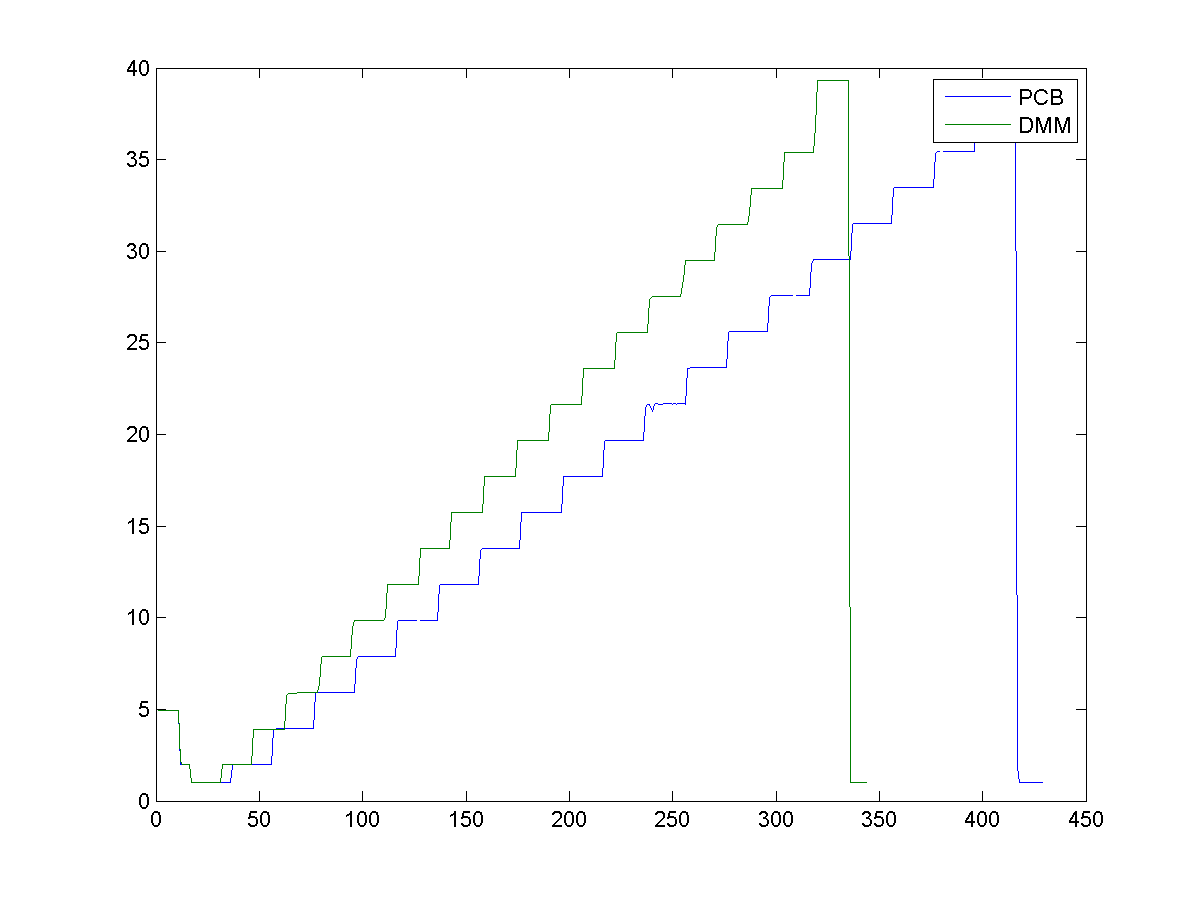
Calibration/BOX1/V2/Before/RawData.png
