sideridispas/SdR_Thesis/Calibration/BOX2/I/After/difference.png

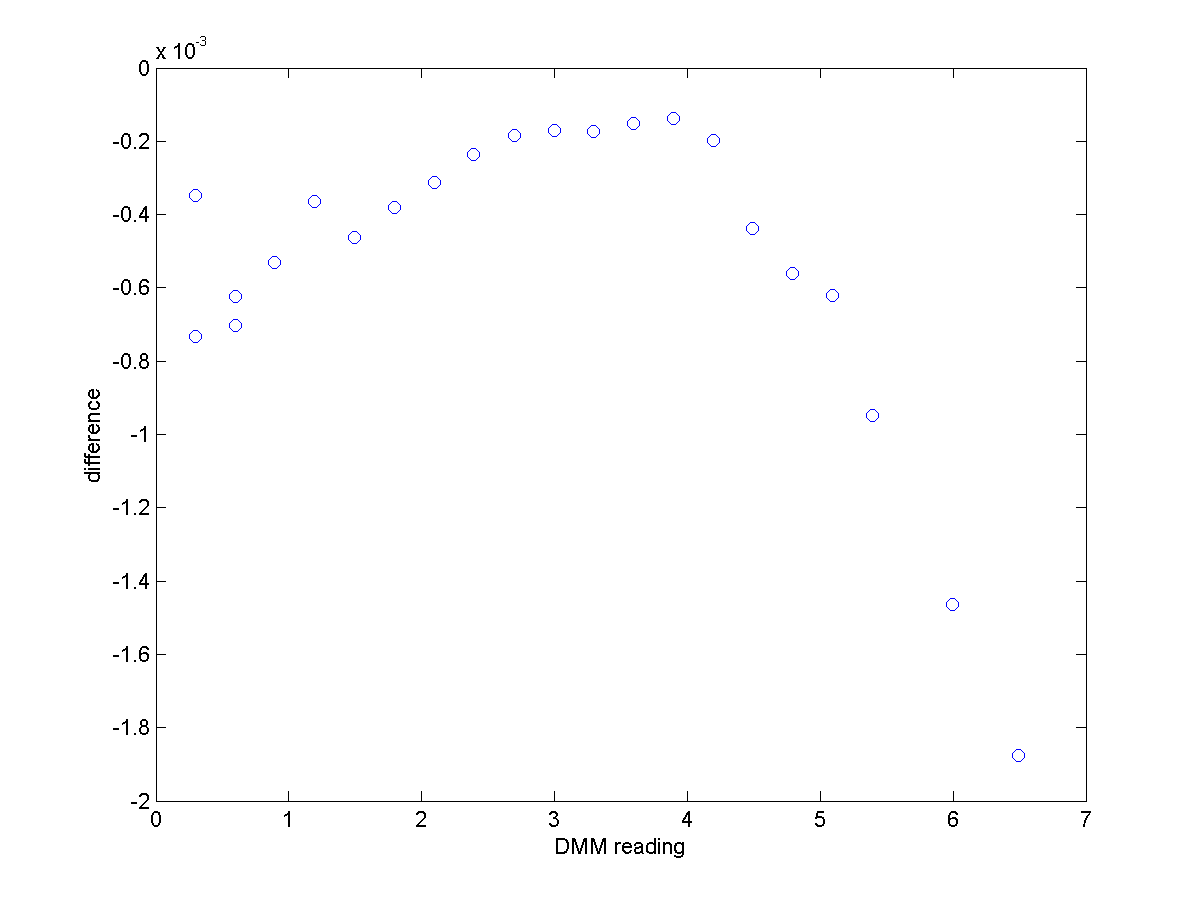
Calibration/BOX2/I/After/difference.png
