sideridispas/SdR_Thesis/Calibration/BOX2/I/After/FailTry1/Means.png

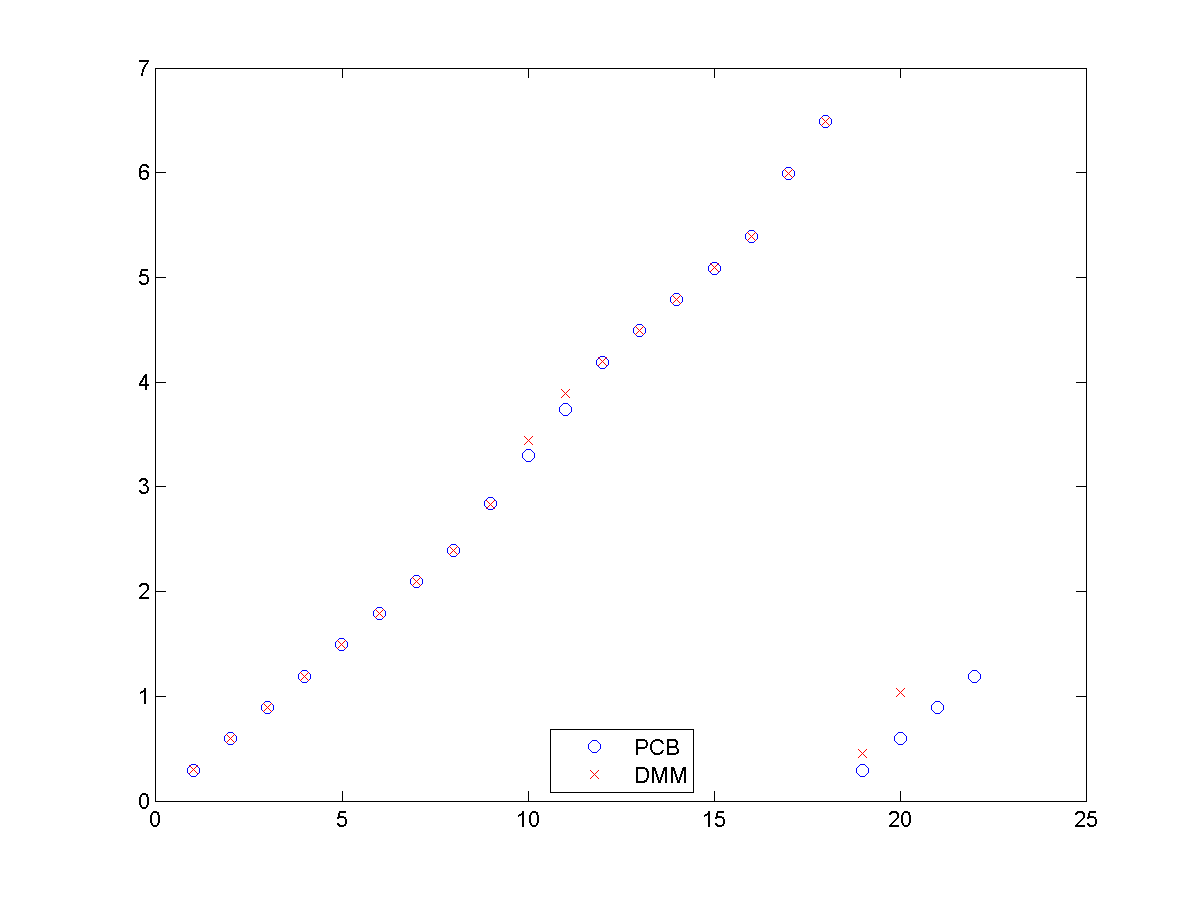
Calibration/BOX2/I/After/FailTry1/Means.png
