sideridispas/SdR_Thesis/Calibration/BOX2/I/After/FailTry1/RawData.png

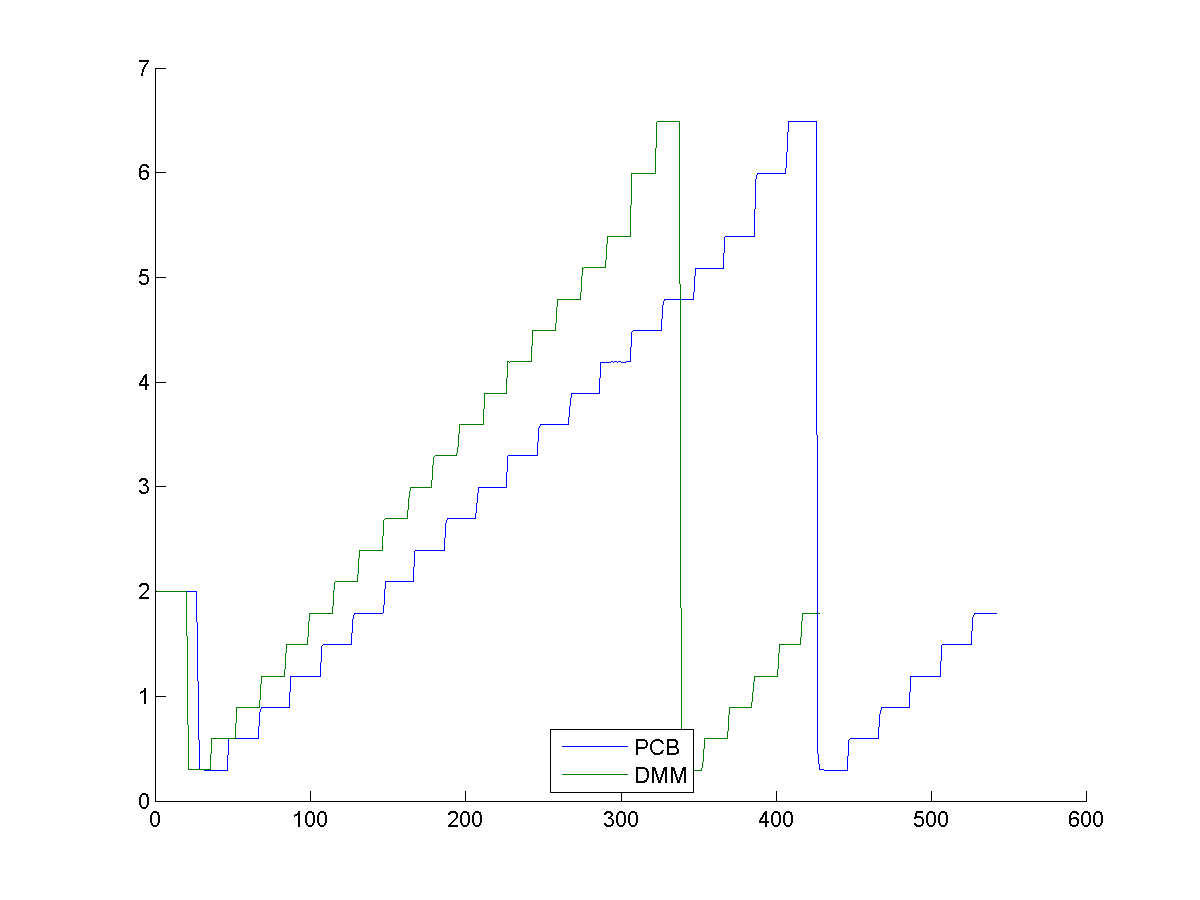
Calibration/BOX2/I/After/FailTry1/RawData.png
