sideridispas/SdR_Thesis/Calibration/BOX2/I/After/Means.png

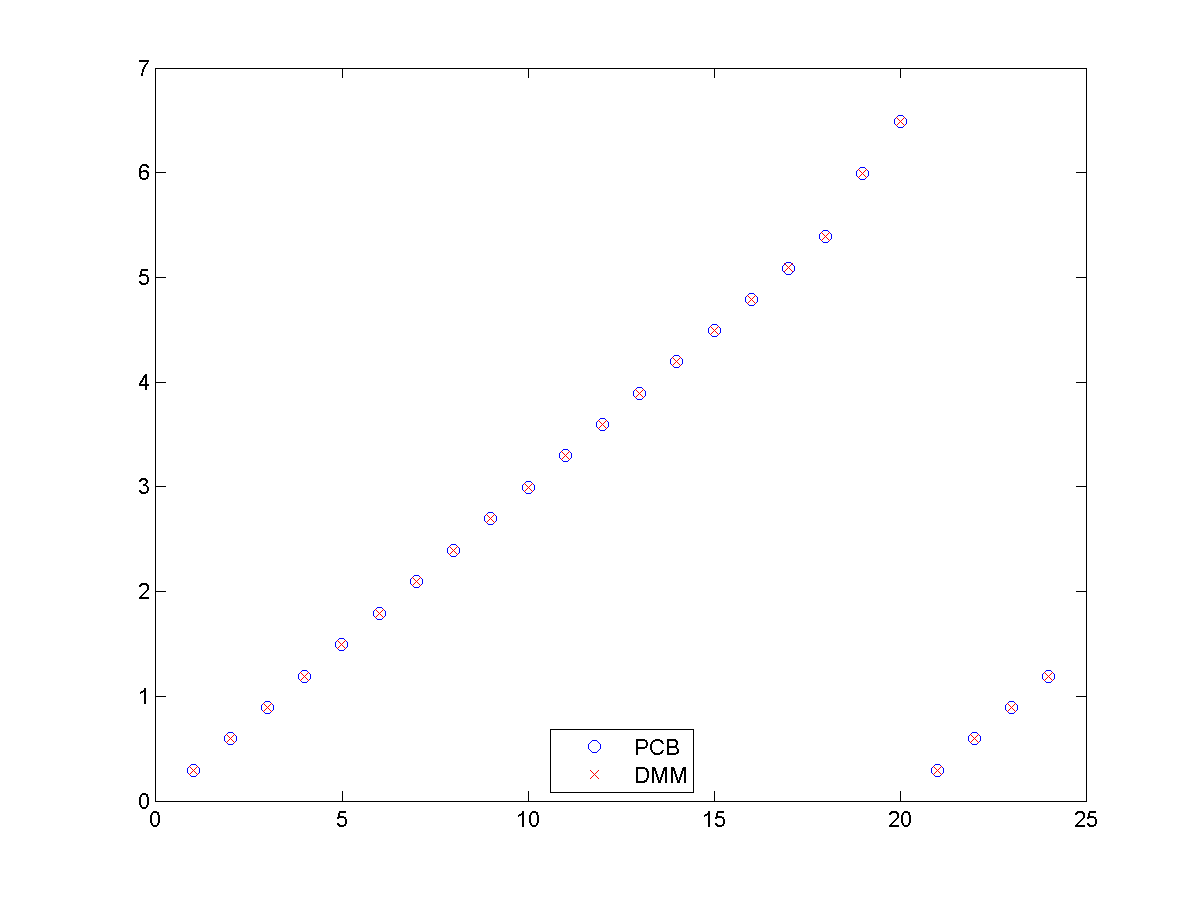
Calibration/BOX2/I/After/Means.png
