sideridispas/SdR_Thesis/Calibration/BOX2/I/Before/difference.png

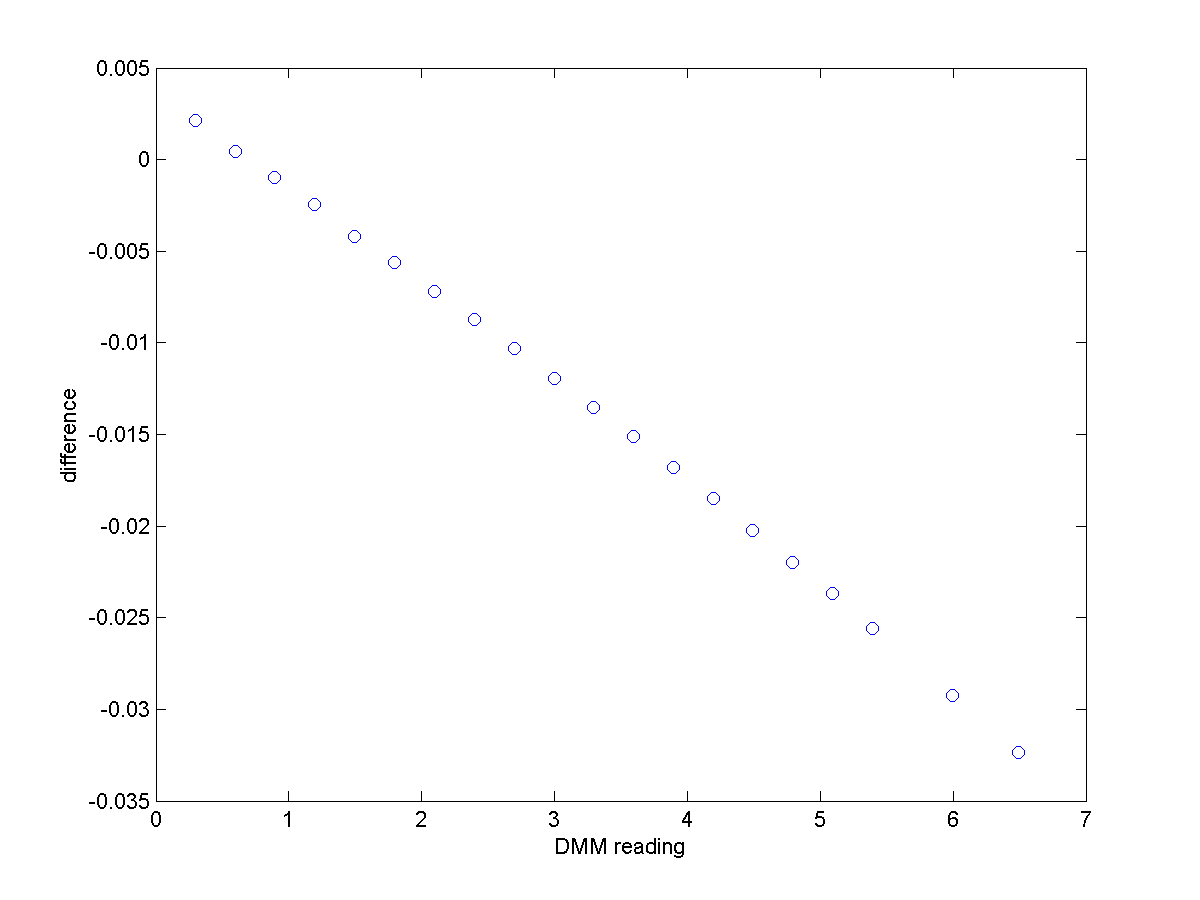
Calibration/BOX2/I/Before/difference.png
