sideridispas/SdR_Thesis/Calibration/BOX2/V2/After/difference.png

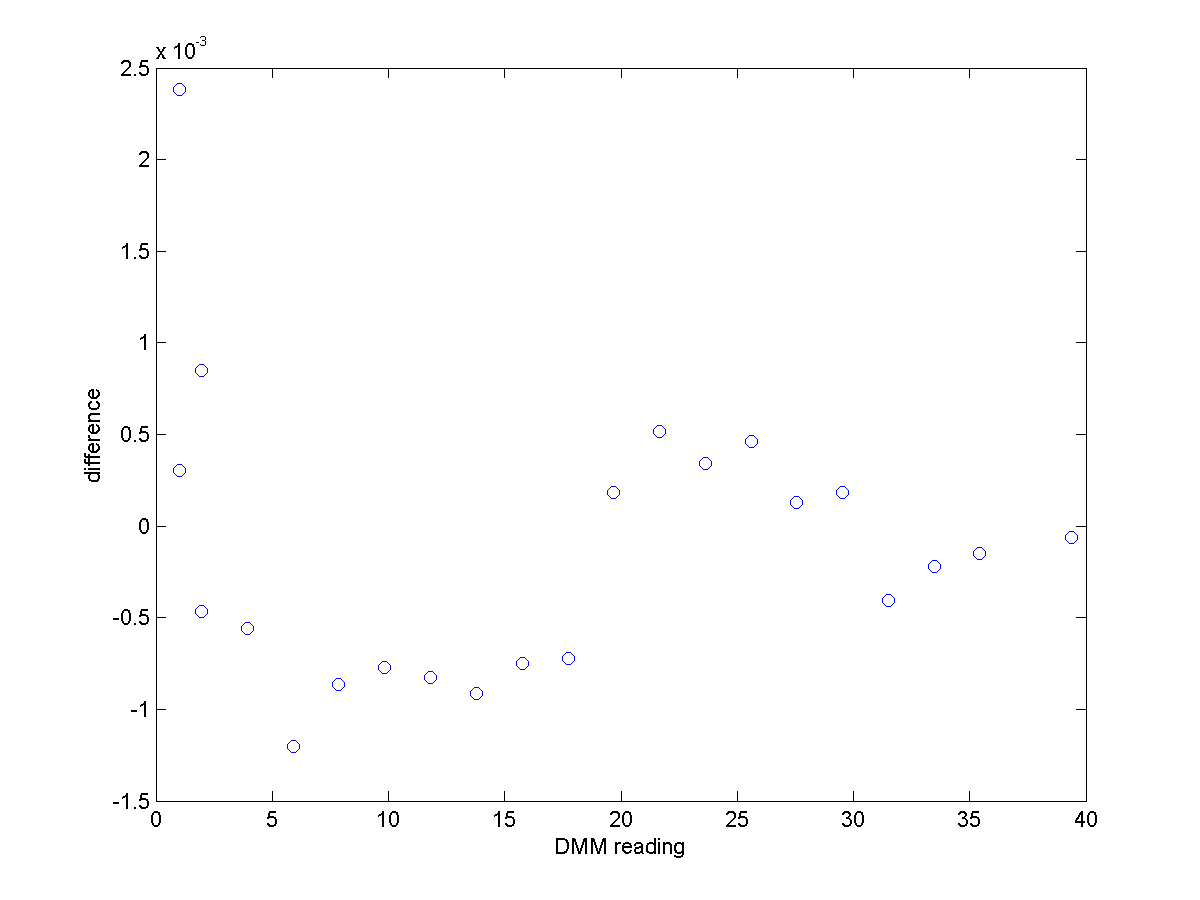
Calibration/BOX2/V2/After/difference.png
