sideridispas/SdR_Thesis/Calibration/BOX2/V2/After/RawData.png

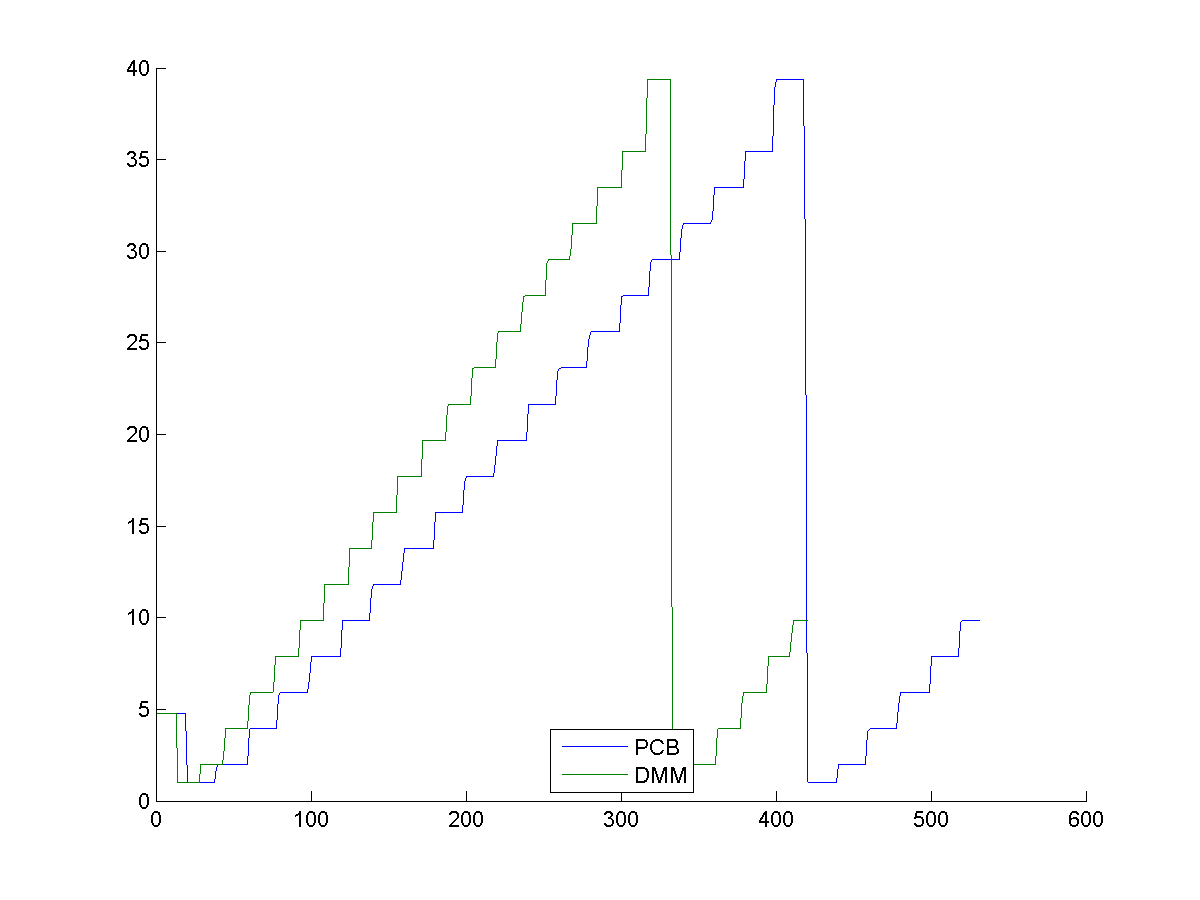
Calibration/BOX2/V2/After/RawData.png
