sideridispas/SdR_Thesis/Calibration/BOX2/V2/After/scatter.png

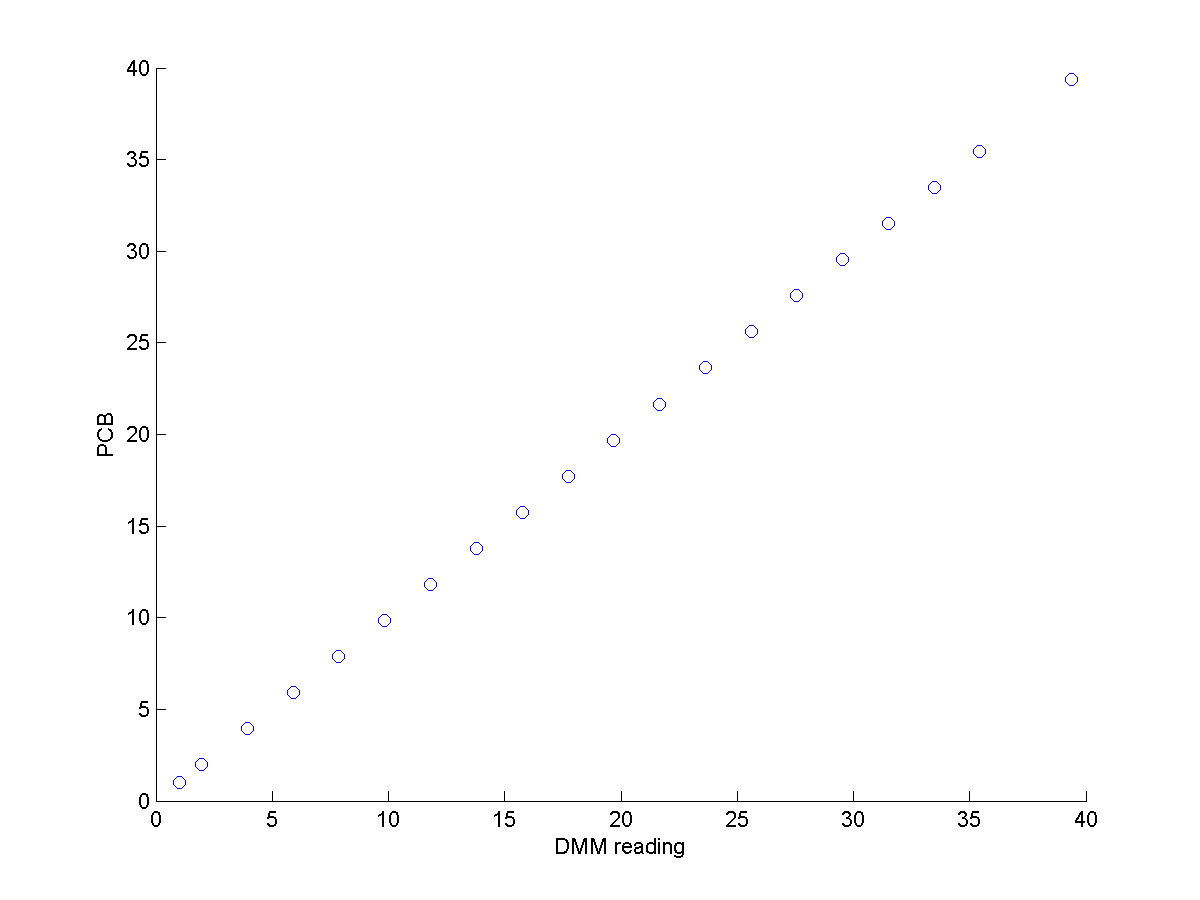
Calibration/BOX2/V2/After/scatter.png
