sideridispas/SdR_Thesis/Calibration/BOX2/V2/After/scatter_trendLine.png

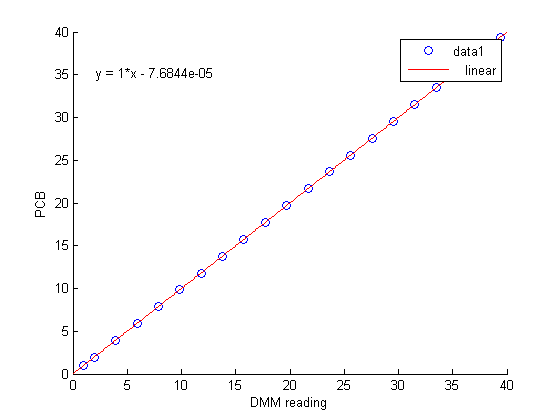
Calibration/BOX2/V2/After/scatter_trendLine.png
