sideridispas/SdR_Thesis/Calibration/BOX2/V2/Before/difference.png

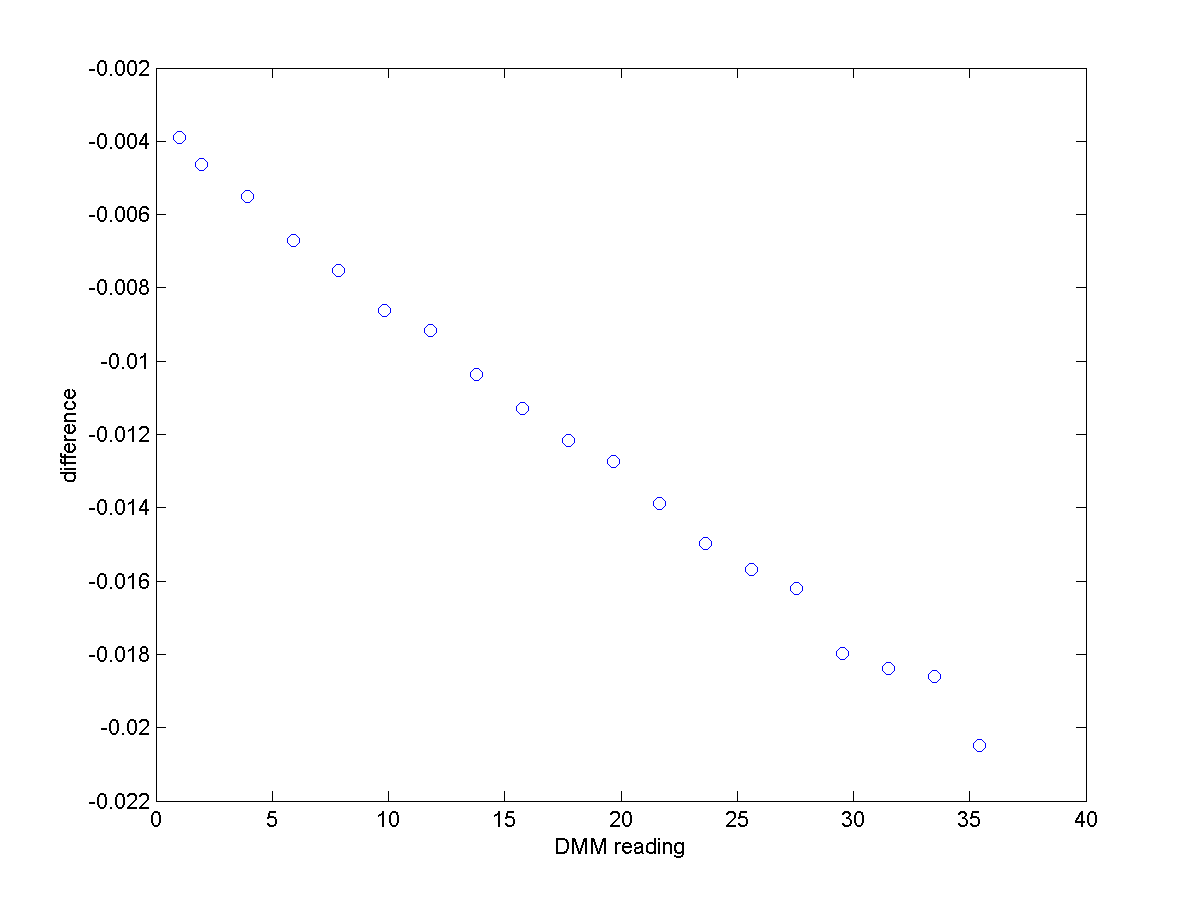
Calibration/BOX2/V2/Before/difference.png
