sideridispas/SdR_Thesis/Calibration/BOX2/V2/Before/RawData.png

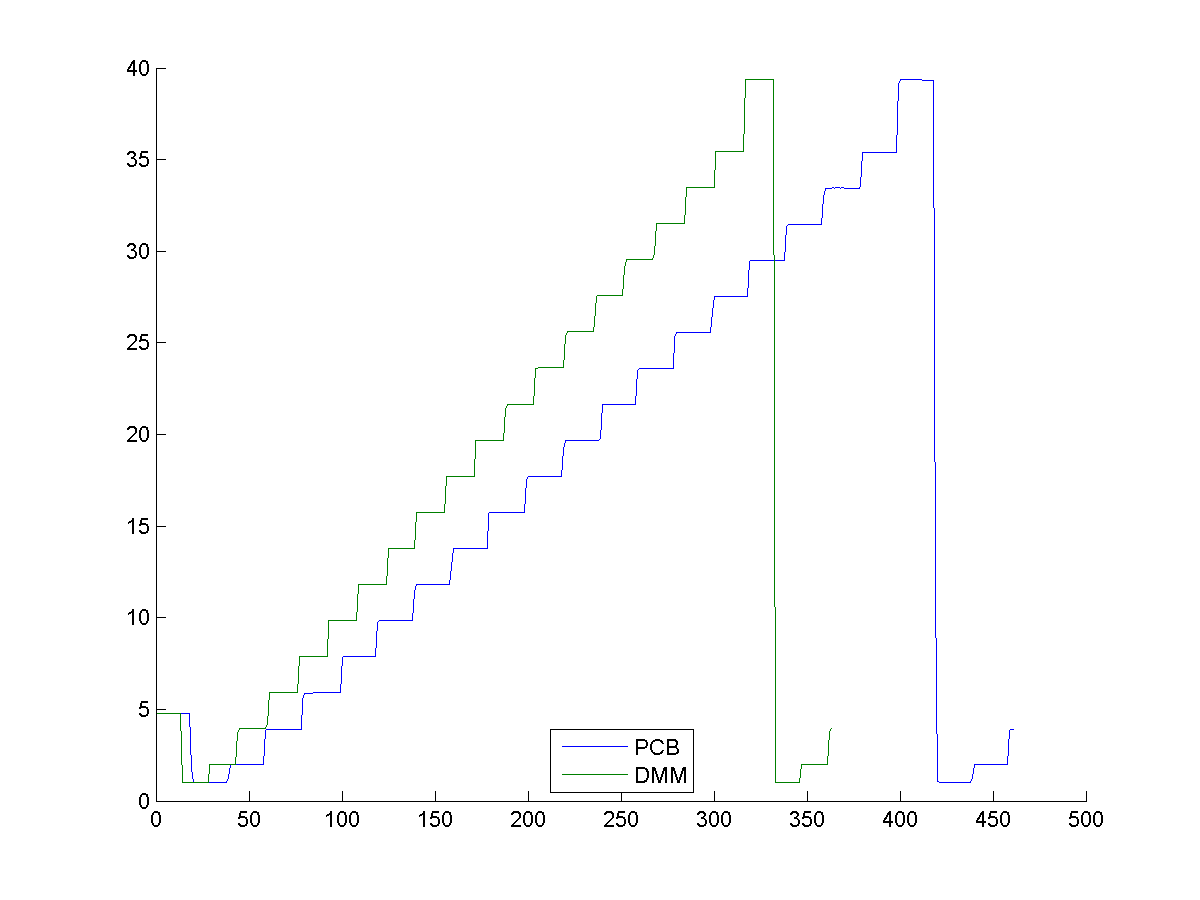
Calibration/BOX2/V2/Before/RawData.png
