sideridispas/SdR_Thesis/PV_BOX1/IC_Libs/ds3234_RTC/ds3234.cpp

#include "ds3234.h"

ds3234::ds3234(const int RTC_CS) {
    _RTC_CS = RTC_CS;
}

int ds3234::RTC_init(){ 
    pinMode(_RTC_CS,OUTPUT); // chip select
    // start the SPI library:
    SPI.begin();
    SPI.setBitOrder(MSBFIRST); 
    SPI.setDataMode(SPI_MODE1); // both mode 1 & 3 should work 
    //set control register 
    digitalWrite(_RTC_CS, LOW);  
    SPI.transfer(0x8E);
    SPI.transfer(B01100000); //60= disable Osciallator and Battery SQ wave @1hz, temp compensation, Alarms disabled
    digitalWrite(_RTC_CS, HIGH);
    delay(10);
}

int ds3234::SetTimeDate(int d, int mo, int y, int h, int mi, int s){ 
  int TimeDate [7]={s,mi,h,0,d,mo,y};
  for(int i=0; i<=6;i++){
    if(i==3)
      i++;
    int b= TimeDate[i]/10;
    int a= TimeDate[i]-b*10;
    if(i==2){
      if (b==2)
        b=B00000010;
      else if (b==1)
        b=B00000001;
    } 
    TimeDate[i]= a+(b<<4);
      
    digitalWrite(_RTC_CS, LOW);
    SPI.transfer(i+0x80); 
    SPI.transfer(TimeDate[i]);        
    digitalWrite(_RTC_CS, HIGH);
  }
}

String ds3234::ReadTimeDate(){
  String temp;
  /*char *FixedLength = (char*)malloc(3); //extra variable to store the data with 2 digits format (leading zeros)
  FixedLength = "";*/
  int TimeDate [7]; //second,minute,hour,null,day,month,year    
  for(int i=0; i<=6;i++){
    if(i==3)
      i++;
    digitalWrite(_RTC_CS, LOW);
    SPI.transfer(i+0x00); 
    unsigned int n = SPI.transfer(0x00);        
    digitalWrite(_RTC_CS, HIGH);
    int a=n & B00001111;    
    if(i==2){ 
      int b=(n & B00110000)>>4; //24 hour mode
      if(b==B00000010)
        b=20;        
      else if(b==B00000001)
        b=10;
      TimeDate[i]=a+b;
    }
    else if(i==4){
      int b=(n & B00110000)>>4;
      TimeDate[i]=a+b*10;
    }
    else if(i==5){
      int b=(n & B00010000)>>4;
      TimeDate[i]=a+b*10;
    }
    else if(i==6){
      int b=(n & B11110000)>>4;
      TimeDate[i]=a+b*10;
    }
    else{ 
      int b=(n & B01110000)>>4;
      TimeDate[i]=a+b*10; 
      }
  }
  /*sprintf(FixedLength, "%02d", TimeDate[4]);
  temp.concat(FixedLength);
  temp.concat("/") ;
  sprintf(FixedLength, "%02d", TimeDate[5]);
  temp.concat(FixedLength);
  temp.concat("/") ;
  sprintf(FixedLength, "%02d", TimeDate[6]);
  temp.concat(FixedLength);
  temp.concat(",") ;
  sprintf(FixedLength, "%02d", TimeDate[2]);
  temp.concat(FixedLength);
  temp.concat(":") ;
  sprintf(FixedLength, "%02d", TimeDate[1]);
  temp.concat(FixedLength);
  temp.concat(":") ;
  sprintf(FixedLength, "%02d", TimeDate[0]);
  temp.concat(FixedLength);*/
  
  temp.concat(TimeDate[4]);
  temp.concat("/") ;
  temp.concat(TimeDate[5]);
  temp.concat("/") ;
  temp.concat(TimeDate[6]);
  temp.concat(",") ;
  temp.concat(TimeDate[2]);
  temp.concat(":") ;
  temp.concat(TimeDate[1]);
  temp.concat(":") ;
  temp.concat(TimeDate[0]);
  return(temp);
}
