sideridispas/SdR_Thesis/(commit log)

2016-01-20 added arduino and processing folders to project
2016-01-21 New folder for whole Demo PCB project, Arduino went to subfolder
2016-01-21 21/01/2016_EndOfDay: Calibrated the measurement with excel trendline
2016-02-02 Tried the DS18B20 temp sensor, alone and 5 device in 1 bus too
2016-02-02 Added the code to main ino file for temperature. Also modified the proccessing file to show temperature too.
2016-02-03 Main ino file: changed the pin of 1wire to PIN4 in order to free the interrupt PIN3. Also created a folder for RTC standalone testing
2016-02-03 Added the RTC functions and object creation in main ino file. Also, created new interrupt (PIN3) that waits the 1Hz pulse from RTC. No timestamp added yet.
2016-02-03 Added timestamp in the main ino file. The proccessing file updated too in order to display timestamp. Lastly, the waiting of 1Hz pulse from RTC is called in loop.
2016-02-10 Tried to communicate with master arduino with no success.. Method used is I2C and the problem is the size of the data we want to transfer. It works until 32 bytes!
    [Arduino_Master.ino.ino, Arduino_VIDemoPCB.ino]
2016-02-11 Added i2c working communication. Data are transfered in 3 packets: V1,V2,I - Temps - Timestamp. There is still a bug that some packets are not received at all...
    [Arduino_Master.ino.ino, Arduino_VIDemoPCB.ino]
2016-02-12 Still trying to fix the packets bug.. Not much changed
    [Arduino_Master.ino.ino, Arduino_VIDemoPCB.ino]
2016-02-12 I think I fixed the bug! Now the master is waiting (interrupt) the slave to have data ready to be transfered.
    [Arduino_Master.ino.ino, Arduino_VIDemoPCB.ino]
2016-02-12 Added new processing file for the master side and modified the arduino code also. Now it prints in Serial like data,data,data,...,data\n
2016-02-12 Updated all files (master/slave/processing) and seems to work. But there is a bug (i think in processing) that crashes the app often..
    [Arduino_Master.ino.ino, Arduino_VIDemoPCB.ino, Processing_Master.pde]
2016-02-12 I think I fixed the bug with processing. It waits for the data with the correct length (12) and after it draws the screen. Seems to work but I noticed uncalibrated data...
    [Arduino_Master.ino.ino, Processing_Master.pde]
2016-02-15 Calibrated the data. Attention because it was not working (totally wrong-noise data and the solution was a selfcalibration command for ADS1256 in the setup function of slave's ino file
    [Arduino_VIDemoPCB.ino]
2016-02-15 Calibrated the data BUT I hope now it is generally calibrated. The difference is that I added the selfcalibration of ADS1256 at startup and seems to work good..
2016-02-17 Made a function for geting the ADC data already calibrated
2016-02-17 added function reg_init() to the ads12xx library. Added function printTemperature to the DallasTemperature library.
2016-02-17 Cleaned the code in slave ino file and also a bit in the IC_Libs. Also I added two more DS18B20 temperature sensors to the 1-wire bus. It seems to work nice (700ms) but sometimes it's starting loopin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
2016-02-18 Slave ino: I used a flag of dallastemperature library for not waiting the temperature conversion. Therefore I also added a manual delay(200) to be sure that the sensors are ready
2016-02-19 Added the code for 20 temp sensors in both ino files. Now 6 packets are being transfered with i2c to the master. The processing has not been updated, so it's not working yet.
    [Arduino_Master.ino.ino, Arduino_VIDemoPCB.ino, ds3234.cpp]
2016-02-19 Added the SD Card module and now the master is logging in a csv file. BUT there is a bug with the data from sensors 15-20 and sometimes they dont have values. Also, I noticed a strange problem when s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
    [Arduino_Master.ino.ino, Arduino_VIDemoPCB.ino]
2016-02-22 I think I fixed the bug with sensors 15-20. The reading of i2c was too slow and maybe the data were changed in between. Also updated the way the data are read from master and its much faster (around 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
    [Arduino_Master.ino.ino]
2016-02-22 Haven't changed a lot. It is correctly logging to csv for a long time. Last file (data10.csv) was also with DC power connected and logging for 46min
    [Arduino_Master.ino.ino]
2016-02-26 Updated the slave ino: Functional 20 temperature sensors connected to the 1-wire bus.
2016-02-26 Nothing changed, just testing. I noticed a bug: sometimes the ADC sends wrong data like negative values etc. After a reset usually it is working properly..
    [Arduino_Master.ino.ino, Arduino_VIDemoPCB.ino]
2016-03-03 Changed the code for Xbee, using SoftSerial library. Now its connected to the virtual serial port at pins 5,6 and with different baud than the serial ouput. There is still the bug with the slave and 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
    [Arduino_CSVfileTransfer.ino, Arduino_Master.ino.ino]
2016-04-06 Added LED indicator on Pin A1. Starting up indicator and a pulse in avery cycle.
2016-04-21 Changed the code of slave for testing with Raspberry. A lot of bugs in the I2C communication. Sometimes it works...
    [Arduino_VIDemoPCB.ino]
2016-04-27 Updated code of slave. Now it is working good with raspberry! But still there is a bug that crashes in the Pi side after a while..
    [Arduino_Master.ino.ino, Arduino_VIDemoPCB.ino]
2016-04-28 Updated code for atmega. It seems to work with a few corrupted characters at the Pi side. Added second LED pulse after sending the last of 6 packets to master
2016-05-24 Not important changes. Created new directory for calibration data and matlab codes
    [Calibrated.csv, Calibrated.xlsx, Calibration.csv, DMM_data.csv, DMM_data_before.csv, PCB_data.csv, PCB_data_before.csv, calibration.csv]
2016-05-25 Added a lot of calibration data. The arduino code is changing because of the calibration
    [Calibrated.csv, Calibrated.xlsx, Calibration.csv, DMM_data.csv, DMM_data_before.csv, PCB_data.csv, PCB_data_before.csv, calibration.csv]
2016-05-25 The box1 is fully calibrated but had a problem with the validation of I calibrated. Maybe matlab issues.. Now created new dir for 2nd box calibration
    [DMM_data.csv, PCB_data.csv, data_2016-05-24-05.csv, data_2016-05-24-07.csv, toCalibrate.xlsx]
2016-05-26 Calibration is COMPLETE! 2 boxes are ready.
    [DMM_data.csv, DMM_data_before.csv, PCB_data.csv, PCB_data_before.csv, data_2016-05-24-05.csv, data_2016-05-24-07.csv, test.xlsx, toCalibrate.xlsx]
